msetsma/desk-rail-system/refs/abfcrttw_usb_hub/README.md

ABFCRTTW 4 ft 7-port USB 3.0 hub (4 USB-A + 3 USB-C on one face, USB-C power port on one end, cable out the other).
Identified from the user's screenshot, 2026-11-02.

Size: about 130 x 30 x 17 mm, aluminium, ~92 g. Listings disagree slightly:
- Amazon B0D3D67D5J: 1.18 x 0.67 x 5.12 in
- Newegg HB437: 3 x 1.7 x 13 cm
- eBay HB436: 1 x 0.66 x 5.3 in
Port positions along the face: estimate from product photos. MEASURE before modelling the pocket.
