msetsma/desk-rail-system/refs/apple_magsafe/README.md

Apple MagSafe Charger (puck), for the ACC-04 phone dock pocket. Researched 2026-11-02.

- 25 W model (2nd gen, Sept 2024 onward): Ø55.5 x 4.5 mm, braided cable Ø3 mm.
  Sources: MakerWorld fit models (makerworld.com/en/models/712190, /2793777). Apple publishes no dimensions.
- Original model (2020-2024): about 5.3 mm thick, slightly wider than 55.5 (estimate, same sources).
- Design pocket: Ø55.8 x 4.6 for the 25 W puck. MEASURE the user's own puck with calipers to confirm which model it is.
