msetsma/desk-rail-system/refs/ducky_pad_pro/README.md

duckyPad Pro, user's own standard case (not the low-profile one)
Source: https://github.com/msetsma/ducky-pad-pro (case/standard), downloaded 2026-11-02.
README.md in this folder is the repo's README; this file is our note.

Case envelope from the STLs (bottom + top): 116 x 103 x 24.7 mm (z -9.2..15.5 in case coords).
Keycaps and the printed encoder knobs add roughly 12-15 mm above the top: estimate, MEASURE.
USB-C exits at the rear right (photo DPP Case Finished.png).
Finish: charcoal matte print, light grey keycaps and knurled knobs, a horizontal top/bottom parting line.
