msetsma/desk-rail-system/refs/laptop_arm/README.md

# LAP-01 laptop tray arm: VIVO STAND-V001L (black)

Single-arm laptop tray desk mount with C-clamp (Amazon B00CM9NG1W, ~$40).

## Sources
- VIVO product page: https://vivo-us.com/products/stand-v001l
- Amazon UK listing (metric): https://www.amazon.co.uk/VIVO-Single-Laptop-Notebook-Mount-Black/dp/B00CM9NG1W
- Kitchen and Bath Authority listing: https://www.kbauthority.com/vivo-stand-v001l-laptop-tray-and-desk-mount.html

## Published dimensions
| Item | Value |
|---|---|
| Tray | 14" x 11.8" (355.6 x 299.7 mm; Amazon UK 35.6 x 30 cm) |
| Pole height | 17" (431.8 mm); KBA lists an 18" centre post on older stock |
| Max arm extension | 16.5" (419 mm) |
| Clamp desk thickness | 0.4"-3.4" (10-86 mm), so a 40 mm 2040 bar fits |
| Capacity | 22 lb (10 kg), laptops up to 17" |
| Movement | tilt +-90 deg, swivel 180 deg, rotation 360 deg; height slides on the pole |
| Material | steel, aluminium; black or white |

## Estimates (MEASURE, from product photos)
- Pole diameter 32 mm
- Arm section 35 x 20 mm, two equal segments
- Clamp plate 60 mm wide (X), 6 mm thick; C-spine 8 mm thick
- Tilt head 60 x 50 x 18 mm
- Tray sheet 3 mm thick; front lip 25 mm high
