msetsma/desk-rail-system/refs/klipsch_r40m/README.md

# Klipsch R-40M references

- `product.json`: Klipsch product JSON (R-40M pair). `photos/klipsch_ca_1..9.jpg`: its 9 product images.
- None of these images (checked 2026-10-28) shows a wall or swivel mount. They show the speaker only: front, side, back (bass port + binding posts).
  So there's no reference image for the mount colour (flange / block / swivel ball). The mount parts' current #1c1c1c (`parts/src/SPK-0[2-4]*.json`) is an assumption, not taken from a reference.
