msetsma/desk-rail-system/PROJECT.md

# Project specifics: desk rail system

Companion to the generic `AGENTS.md`. Update this file when project facts or quirks change.

## Files and tools
- Assembly: `desk_rails.solidcraft` (SolidCraft, driven over MCP). It holds only linked part files placed
  with joints from the skeleton parameters. Live app:
  `solidcraft --control 27878 --allow-path "C:\Users\<user>\DEV\CAD\desk"`.
- Skeleton: `skeleton/params.json`, the shared layout and `MEASURE` parameters. Both the assembly and
  every layout-driven part import it. It stores **expressions only** (no values): for numbers, use
  `tools/skeleton_values.py` (`values()`, evaluated with the CLI, cached by hash) or an eval report.
  `skeleton/hw_placements.json` holds the hardware placements.
- Parts: source of truth is the part's **generator** when its script says `"generated_by": "<gen>.py"`
  (most parts: `parts/src/*_gen.py`, `FRM-gen.py`, `parts/lib/src/gen_lib.py`); otherwise the hand-written
  script `parts/src/<PN>_<Name>.json` itself. Never hand-edit a generated script: the next generator run
  overwrites it. A script may name a vendor file to start from (`"input": "refs/..."`). New parts start
  from `parts/_template.json` (materials), get a generator, and follow `docs/PART_BUILD_SPEC.md`.
  - `parts/<PN>_<Name>.solidcraft` are **frozen** outputs: a STEP import plus materials, colours and
    metadata. They're what the assembly links, at about 1 s per insert. Don't edit them by hand.
  - Each part's build history is in `build/parts_hist/<stem>.solidcraft`. Open that one to inspect a part,
    then change the script.
- **Edit loop (fast):**
  1. Edit `skeleton/params.json` or a part script.
  2. Run `python tools/regen_parts.py`. It first re-runs stale generators (generator newer than its script,
     or skeleton newer and the generator uses `skeleton_values`), then rebuilds only the parts whose script
     or skeleton changed, in parallel. It prints the components to refresh. It re-reads the part list after
     the generators, so a part a generator just created or renamed builds in the same pass, and it warns about
     frozen files left without a script (`git rm` them).
  3. **1-3 parts changed:** in the live assembly, run `component.update_links {"component": "<name>"}` for
     each (~0.3 s each), plus `parameters.import` of the skeleton if it changed. **More than that** (any
     skeleton change usually touches ~25 parts): rebuild the assembly (below, ~20 s), then `new_design` +
     `open`. **Never use the bare `update_links {}`**: it re-evaluates every link (~40 s).
     Removing or renaming a skeleton parameter is a skeleton change too. When a change only retires a
     parameter, leave it unused (say so in its comment) and delete it with the next real skeleton change.
- Parameter sweep (parallel, on private copies): `python tools/sweep.py`.
- Console (ACC-00): `parts/src/ACC_layout.py` is the shared layout (bays, device pockets, phone stand) read by
  the bay generator and the device generator; it isn't a skeleton parameter set, so editing it reruns only those
  generators.
- Other tools: `audit.py` (structure and balance), `eval_bodies.py` (body -> part/placement names), `svg2dxf.py`,
  `spk_laid.py` (laid-speaker solve for variants).
- Layout variants (own assembly file, main design untouched): `python tools/build_variant.py <name>` builds
  `variants/<name>/variant.json` (skeleton overrides, `speakers: hung|laid`) into its `out` file, with the
  variant skeleton and its skeleton-driven parts under `variants/<name>/`. `desk_62x32` ->
  `desk_rails_62x32.solidcraft` (D17). Re-run it after a skeleton or part change; it re-solves the laid speaker
  placement and laptop tray height. Checks take `--design desk_rails_62x32.solidcraft`. It can run in parallel
  with `build_assembly.py`: `assembly_finish.py` names its scratch files after the design
  (`build/<design>_finish.json`, `build/<design>_eval.json`).
- Rebuild the whole assembly from scratch (~20 s): `python tools/build_assembly.py --out desk_rails.solidcraft`.
  Build straight to that path (the design name comes from the build path, so a copied file keeps the
  wrong name). Run `new_design` in the live app first, then `open`.
  `tools/assembly_finish.py` adds materials, properties, views and display rows.
- The desk (DSK group) stays in the main assembly rather than a nested file, as tested on 2026-10-28:
  - a linked sub-assembly is flattened to one BOM row
  - links don't chain, so every change becomes a two-step refresh
  - all of DSK costs < 1 s to insert
- Legacy single-timeline model and `docs/COMPLIANCE_PLAN.md`: removed 2026-10-31; recover from git history if needed.
- Headless CLI: `solidcraft-cli run <script.json> [--in X] --save Y`.
- Narrow clearance after a change: `python tools/near_check.py <body prefixes>` (~4 s). It checks each
  changed body against its bbox neighbours and skips hardware-on-extrusion contacts. Open mesh bodies
  (the converted chair) can't be checked exactly; it falls back to their bboxes (`BBOX ... inspect`).
  `--print-params` prints the commands for the live app. `--include-mating` keeps the contacts (slow).
  New catalog hardware that seats face-to-face on an extrusion (end caps, brackets) must be added to
  `near_check.MATING`, or its exact contact check runs for minutes.
  Its scratch files are per design, so checks on the main design and a variant can run in parallel.
  It passes `skip_within: component`, so bodies in the same group (ACC-00 devices in their bays) are never checked
  against each other: run `inspect.clearance` on those pairs without it.
- Sightlines + laptop fit: `python tools/sightlines.py [--set lap_az=36 ...]` (seconds). Ray-casts from the Eye to the
  speaker baffles, monitor screens and laptop screen, and box-checks the laptop against monitors, speakers and the frame.
  A coarse grid search can miss a small block: re-run the chosen point at the default resolution.
- Full check: `tools/check.py` (slow; run only on request). BOM: `tools/bom.py` -> `BOM.md`.
- Decision log and extrusion rules: `docs/EXTRUSION_GUIDE.md`. Cite rule IDs (J*, M*, P*, W*) and
  log decisions (D*) there.

## Standards and constraints
- Extrusion: Misumi HFS5 (5 series) only, ordered black anodized as HFSB5 (D23, same section); the 8020 and V-slot variants are retired. Profiles come from
  `profiles/misumi_hfs5_*.dxf`, so `rail_l` and `rail_s` follow the profile and aren't free parameters.
- Buy, don't fabricate: joints use catalog parts. Vendor machining is OK, and user drilling is OK when
  the user agrees.
- Desk frame: DeskHaus Apex Pro 4-leg (Jiecang OEM), finished in Silver. No CAD exists; it's modelled
  from the dimension sheet and photos in `refs/`. `MEASURE` parameters are estimates.

## Conventions (for the cad-best-practices skill)
- Part numbers belong to part **files**, not occurrences. Group components `DSK-00`, `FRM-00`, `HW-00`,
  `MON-00`, `SPK-00`, `PC-00`, `INP-00`, `LAP-00`, `CHR-00`, `ACC-00`, `REF-00`; parts `DSK-01`…, library `HW-L01`…. Add `Rev X` when a
  part is released. `DSK-00` is grounded. The full list is in `docs/PART_BUILD_SPEC.md`.
- One file per left/right pair when a 180° turn about Z reproduces the other side. Mirror-image parts
  (side rails, hanger plates, keyboards) get two files.
- Purchased reference models (speaker, mouse, chair, laptop, console devices) may hold several bodies, one per finish.
- Appearance: purchased parts get their real finish:
  - DeskHaus Silver powder-coated steel frame #a8acaf (refs/apex_pro)
  - black anodized extrusion (HFSB5) and gussets (HBLFSNB5) #1d1e20 (D23)
  - joining plates, 45 deg brackets and hanger plates: painted / powder-coated black by the user #1a1a1a
  - black polyamide end caps (HFC5-4040-B) #141414
  - black standoffs and HBLTDB5 #1d1e20; M6x55 black oxide #2b2b2b
  - printed console parts (ACC-01..07) charcoal #34373b, inlay light grey #c9cccf
  - PC walnut slat front #634433
  - dark grey PET felt panels #3a3c3f (estimate, confirm from samples)
  - desktop (IKEA KARLBY walnut veneer, 503.352.08) #6b4a32, estimated from product descriptions

  Reference geometry is red.
- Materials are the custom set in `parts/_template.json`. They are stored in each part as
  `com.setsma.desk {Material, ReleaseState, Source}`, and the assembly re-applies them, because links
  don't carry them.
- Masses are envelope estimates: legs, PC case and monitors are solid blocks, so `mass_g` overstates them.

## SolidCraft capabilities (spike 2026-10-28, CLI v0.24.0)
- Script format: `{"commands":[{"command": id, "params": {...}}]}`. Use forward slashes in paths.
- `solidcraft-cli` builds and saves headless while the live app is open. Parallel runs are fine.
- Linked parts: `component.insert_design {path, name, parent?, reuse?}` stores a STEP copy plus a link.
  It only refreshes on `component.update_links {}`. `reuse:true` adds another occurrence of the same
  component.
- **Linked parts can't read assembly parameters**: there's no per-occurrence override, and insert_design
  ignores extra keys. Layout-driven parts import the shared skeleton instead with
  `parameters.import {path}`. Re-importing overwrites the values and rebuilds (tested).
- **Standard placement**: a planar joint from the root origin to the part's local origin:
  `{type:"planar", a:{occurrence:0, point:[0,0,0], z:[0,0,1], x:[1,0,0]}, b:{occurrence, point:[0,0,0], z:<zl>, x:<xl>}, flip:true, values:["<x>","<y>","<yaw>"], offset:"<z>", angle:"0 deg"}`.
  - `zl` and `xl` are the part-local directions that land on world +Z and +X; they encode any fixed
    rotation (a fixed half turn is `xl:[-1,0,0]`).
  - `angle:"0 deg"` is required. Without it, SolidCraft adds a half turn whenever that turns b less.
  - Only parametric yaws go in `values`. The placement follows parameter changes.
  - `occurrence.move` and `joint.origin` points take numbers only. `joint.drive` replaces expressions.
- Metadata: `component.metadata.set {component, part_number, description, revision, properties}` and
  `document.metadata.set`. Linked parts copy document metadata **once, at insert**. Material and free
  properties don't come through.
- Materials: `material.create {name, density_g_cm3}`, `material.assign {bodies, material}`.
- BOM: `assembly.bom {levels, group_by, path}`. The CSV has no material column; the JSON includes properties.
- Appearance: `appearance.assign {bodies|components, color}`; precedence face > body > component > material.
- Views: `view.save {name, camera:{target, yaw, pitch, distance}}`. Yaw 0 looks from the front (-Y);
  yaw < 0 orbits toward +X. `snapshot --view NAME` works.
- **No display states**: use config rows that suppress link features
  (`config.row {name, values:{"suppress:<feature>": true}}`). Rows: Full, Frame only, No desktop,
  Monitors + speakers, Rails only, Desk only, Desk + rails, No chair. Named views don't carry a row:
  pair `Rails`/`RailsBack`, `Desk` and `DeskRails` with their row by hand.
- Home view (`view.home`) always fits the whole model; its zoom isn't configurable. Use the `Overview` view.
- Naming: `timeline.rename`, `timeline.group {name, features}`. `solid.extrude` ignores `name` (the body
  stays `Body1`), so use `body_name` and check it. Patterns, chamfers and mirrors take `name`.
- `solidcraft-cli script` fails on designs with components (#886).

## Known quirks
- SolidCraft `body.rename` renames the string across all features.
- The MCP call timeout moves long calls to the background, and `pending` may say nothing is running.
- MCP `open` of a path whose design is already loaded (even after the file changed on disk) keeps the
  in-memory design. Run `new_design` first, then `open`.
- Linked inserts split multi-lump bodies into separate bodies (`PC_FrontSlats (2)` …).
- `component.insert_design` and `update_links` **re-evaluate the part's history**: an insert costs about
  what the part takes to build. Profile slow parts with
  `solidcraft-cli run <script> --timings --profile --json-out t.json`.
  - Booleans on the detailed HFS5 DXF profile are the expensive case: one `solid.hole` with 8 counterbores
    took 46 s.
  - The assembly build was ~120 s before parts were frozen, the two side rails ~105 s of it (2026-10-28);
    with frozen links it is ~20 s.
- `component.update_links {}` re-evaluates every link, even unchanged ones (~40 s). Pass `component`.
- Full assembly builds log repeated non-fatal `knot vector consists single value` panics (source part
  not yet identified; likely a vendor NURBS body). The run still succeeds.
- Edge/face pick points (`solid.chamfer`/`fillet` `edges`, `appearance.assign` `faces`) and `sketch.create`
  origins are plain numbers. Generators compute them from `skeleton_values.values()` or their own local
  constants (AGENTS §3). DSK-02 broke when a hand-typed point missed the new `ts_h`; the stale stored
  skeleton values had also put the PC-01/02 fillet picks on the wrong edges.
- Line endings: `.gitattributes` stores all text as LF; Windows generators may write CRLF and git
  normalises on add, so don't hand-preserve line endings. Working copies can still be CRLF (e.g.
  `FRM-gen.py`): edit scripts that match multi-line text must convert the pattern to the file's line ending.
- SPK-01's logo outlines live in `refs/klipsch_r40m/R40M_logo_sketch.json` (a JSON in `parts/src` would be taken for
  a part script). `regen_parts.py` doesn't track that file: after editing it, run `regen_parts.py --force SPK-01`.
- `inspect.clearance` can report `0.000 mm` for a real 0.1 mm gap (seen on the laptop clamp vs the 2040 bar).
  Treat sub-0.2 mm "near" values as contact-level, not as a measurement.
- MCP `parameters.export` returns the full text even when given a `path`. `component.list` on the full
  assembly is large; use `solidcraft-cli ... --results --json-out` and summarize it.
- Eval names a body in a repeated placement with its occurrence path:
  `Leg (DSK-00 Desk frame:1/DSK-04 Leg:3)`.
- `solidcraft-cli eval <script> --in X` ignores the script; use `run --in X --save tmp`, then `eval`.
- An `XZ` sketch's v axis is world **-Z** (normal +Y): generators negate z (`FRM-gen._pt`). Expression points also work in
  `sketch.arc.three_point`; drawing arcs through their 45 deg point avoids CW/CCW sign slips. There's no `parameters.set`
  in scripts: inline the expressions.
- `sketch.rectangle.*` rejects expressions; use `sketch.line` with expression points. `sketch.create`
  takes a numeric origin only, and `{face, body}` needs `index`.
- Mesh imports (`file.insert_mesh`: STL/OBJ/glTF) stay mesh bodies: no STEP export, and `insert_design` refuses a
  design with only mesh bodies. Vendor meshes go through `tools/mesh_step.py` (planar-face STEP, imports as B-rep;
  ~2 s linked insert per 11k triangles; the chair keeps the full 35k for looks). Keep touching pieces unwelded: edges with 3+ faces break STEP export. Reduce glTF meshes by vertex clustering
  (`MON-03_convert._cluster`): quadric decimation (fast-simplification) tears them open along UV seams, and once
  welded it hardly reduces them.
  DWG -> DXF: LibreDWG `dwg2dxf` (C:/Users/2015m/cad_tools/libredwg/), see refs/herman_miller_mirra2/README.md.
- Misumi: 3D CAD is generated server-side (slow) and needs a login or email. HFS5 extrusion 3D
  CAD isn't offered; profiles come from DXFs in `profiles/` / `refs/ext_*`.
- README image (`docs/images/desk_overview.png`): model screenshots (`screenshot source:model`) always draw
  black edges, which turn the chair mesh into a wireframe, and `view.visual_style` doesn't affect them. Render it
  with `render.settings.set` (setup `Readme`: camera target [0,0,720], yaw 0.6, pitch 0.42, distance 2700,
  1600 x 1000, background [46,51,64]) then `render.start {setup, integrator:"raytrace", raytrace:{budget:"studio"}}`
  and `render.export` (~10 s). GitHub caches README images for a few minutes.
- Rendering: the full assembly (~330k triangles) exceeds the CPU preview cap (262k); use CPU raytrace with
  `budget: "studio"` or GPU path. The GPU path tracer needs Vulkan, but the Windows viewport defaults to D3D12
  (issue #7623), so `%APPDATA%\SolidCraft\graphics.json` sets `{"backend": "vulkan"}` (2026-10-29). The first
  GPU render compiles shaders (~3 min, ~7 GB RAM). `assembly_finish.py` recreates the `Readme` render setup on every
  rebuild; any other setup saved in the assembly (e.g. `Hero`) is lost by a rebuild unless added there.
