msetsma/desk-rail-system/refs/klipsch_r40m/photos/klipsch_ca_1.jpg

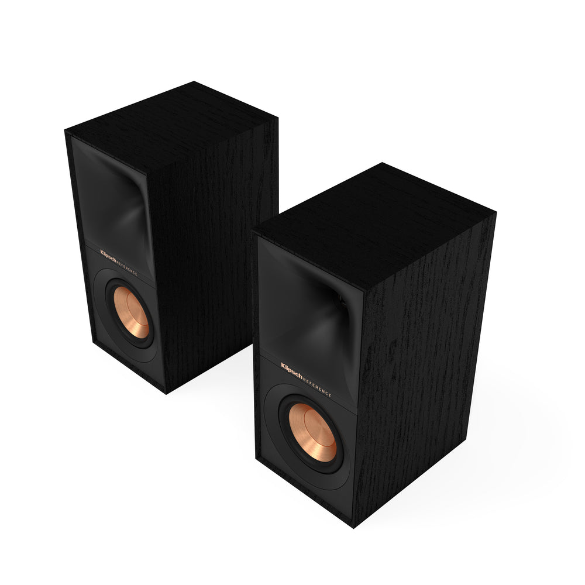
refs/klipsch_r40m/photos/klipsch_ca_1.jpg
