msetsma/desk-rail-system/refs/klipsch_r40m/photos/klipsch_ca_6.jpg

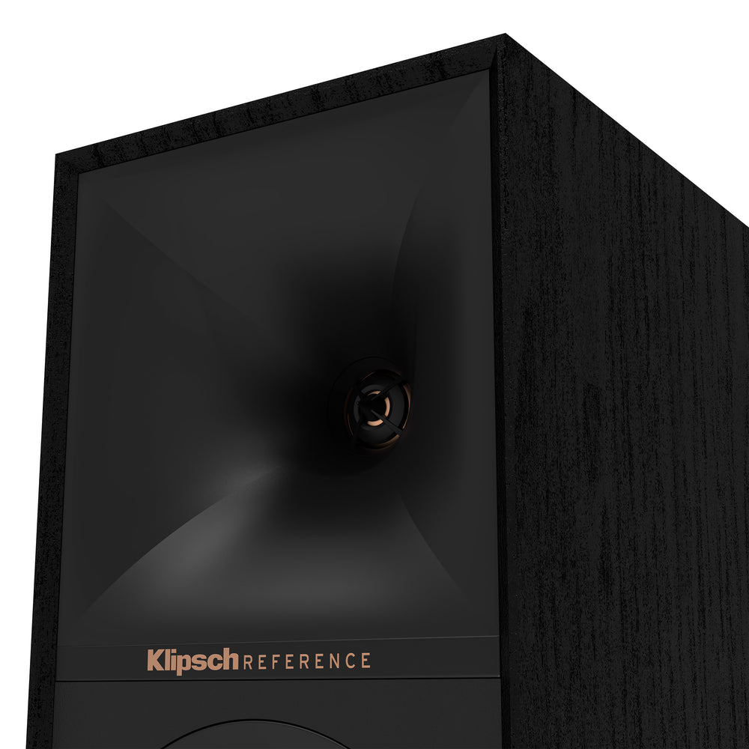
refs/klipsch_r40m/photos/klipsch_ca_6.jpg
