msetsma/desk-rail-system/refs/visual_black_felt/HBLTD5_drawing.png

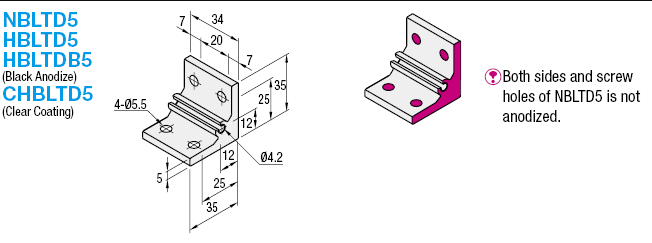
refs/visual_black_felt/HBLTD5_drawing.png
