msetsma/desk-rail-system/refs/visual_black_felt/HFC5_drawing.png

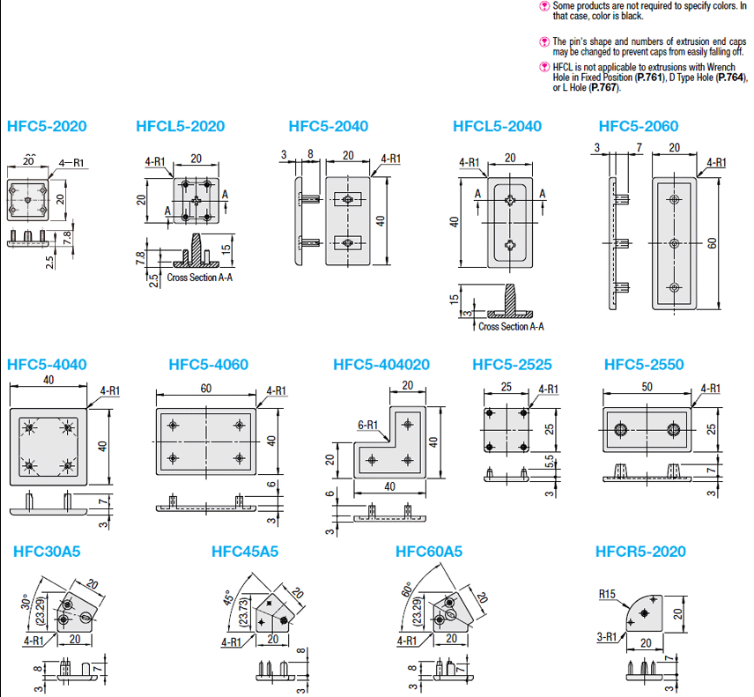
refs/visual_black_felt/HFC5_drawing.png
