msetsma/desk-rail-system/refs/visual_black_felt/HFCB5_drawing.png

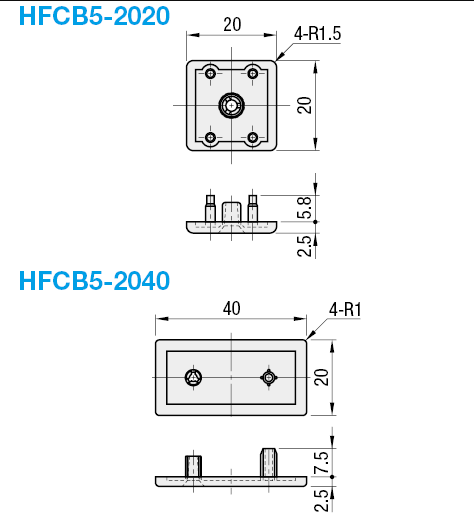
refs/visual_black_felt/HFCB5_drawing.png
