msetsma/desk-rail-system/BOM.md

# Bill of materials

Generated by `tools/bom.py` from the part-number metadata in `desk_rails.solidcraft` (`assembly.bom`). Do not hand-edit; rebuild.

52 part numbers, 120 items.

| Group | Part numbers | Items |
|---|---|---|
| ACC-00 Crossbar console | 12 | 12 |
| CHR-00 Chair | 1 | 1 |
| DSK-00 Desk frame | 5 | 13 |
| FRM-00 Monitor rail frame | 10 | 16 |
| HW-00 Frame hardware | 8 | 58 |
| INP-00 Input devices | 4 | 4 |
| LAP-00 Laptop | 3 | 3 |
| MON-00 Monitors | 2 | 2 |
| PC-00 PC under-desk | 3 | 3 |
| SPK-00 Speakers | 4 | 8 |

## ACC-00 Crossbar console

| Qty | Part number | Description | Material | Rev | Notes |
|---|---|---|---|---|---|
| 1 | ACC-01 | Desk cable grommet (printed) | ASA/PETG print (ABS density) | A |  |
| 1 | ACC-02 | Console audio bay (printed) | ASA/PETG print (ABS density) | A |  |
| 1 | ACC-05 | Console duckyPad bay (printed) | ASA/PETG print (ABS density) | A |  |
| 1 | ACC-06 | Console inlay line (printed, light grey) | ASA/PETG print (ABS density) | A |  |
| 1 | ACC-07 | Phone stand (printed) | ASA/PETG print (ABS density) | A |  |
| 1 | ACC-11 | Focusrite Scarlett Solo 3rd Gen interface, 144 x 44 face x 96 deep, red anodised body, front jacks/knobs proud toward -Y, rear USB-C + RCA toward +Y | Al 6063-T5 | A |  |
| 1 | ACC-12 | ABFCRTTW 7-port USB 3.0 hub, 130 x 30 port face x 17 deep, 4 USB-A then 3 USB-C along +X in the -Y face, captive cable d3 x 12 stub out of the -X end (back half) | Al 6063-T5 | A |  |
| 1 | ACC-13 | Apple iPhone 16 Pro Max in a case, landscape, 168 x 82 x 12 (case), screen toward -Y inset 1 mm, camera plateau 1.5 mm proud on the back (+Y) at +X/+Z | PC | A |  |
| 1 | ACC-14 | Apple MagSafe Charger 25 W puck d55.5 x 4.5, charging face toward -Y, aluminium back, cable d3 x 20 radially out of the bottom (-Z) | Al 6063-T5 | A |  |
| 1 | ACC-15 | USB-C fingerprint reader dongle, 30 x 15 x 7, round sensor d9 on the -Y face, USB-C plug 6.5 out of the +X end | ABS | A |  |
| 1 | ACC-16 | duckyPad Pro in the user's standard printed case (116 x 103 x 24.7), 20 keycaps 4 x 5 at 19 mm, 2 knurled knobs (rear right), 2 buttons (front right), OLED | ABS | A |  |
| 1 | ACC-17 | KVM key | ABS | A |  |

## CHR-00 Chair

| Qty | Part number | Description | Material | Rev | Notes |
|---|---|---|---|---|---|
| 1 | CHR-01 | Herman Miller Mirra 2 work chair, Butterfly (Suspension) back, adjustable arms | ABS (stand-in for glass-filled nylon frame/base and polyester textile); steel cylinder | A |  |

## DSK-00 Desk frame

| Qty | Part number | Description | Material | Rev | Notes |
|---|---|---|---|---|---|
| 1 | DSK-01 | Desktop slab desk_w x desk_d x desk_t (IKEA KARLBY walnut veneer, 503.352.08), with the ACC-01 cable grommet hole (grom_d at x 0, y grom_y | Walnut | A |  |
| 2 | DSK-02 | Apex Pro (Jiecang OEM) top support | Steel powder-coated | A |  |
| 4 | DSK-03 | Apex Pro collapsing channel bar (one of 4 | Steel powder-coated | A |  |
| 4 | DSK-04 | Apex Pro (Jiecang OEM) 3-stage lifting column, narrowest at the top (DeskHaus renders) | Steel powder-coated | A |  |
| 2 | DSK-05 | Apex Pro foot | Steel powder-coated | A |  |

## FRM-00 Monitor rail frame

| Qty | Part number | Description | Material | Rev | Notes |
|---|---|---|---|---|---|
| 2 | FRM-01 | Upright, Misumi HFSB5-4040, L = up_below + hang_t + desk_t + up_above | Al 6063-T5 | A | access holes for the crossbar and side-rail / speaker-arm anchors (M2) |
| 2 | FRM-02 | Crossbar, Misumi HFSB5-2040 (40 in Z, 20 in Y), L = 2*up_xc - rail_l (between upright inner faces) | Al 6063-T5 | A | both ends tapped M5 for end anchors (M1, D8) |
| 1 | FRM-03L | Side rail L, Misumi HFSB5-4040 drilled for 4 M6 through-bolts (D9) | Al 6063-T5 | A | rear end tapped M5 (M1, D8) |
| 1 | FRM-03R | Side rail R, Misumi HFSB5-4040 drilled for 4 M6 through-bolts (D9) | Al 6063-T5 | A | rear end tapped M5 (M1, D8) |
| 3 | FRM-04 | Stile, Misumi HFSB5-2040 (40 in X, 20 in Y), L = bar2_z - bar1_z - rail_l (between crossbars) | Al 6063-T5 | A | both ends tapped M5 for end anchors into the crossbar slots (M1, D7) |
| 1 | FRM-05 | Privacy panel, 12 mm PET felt, W = desk_w - 2*pnl_side, H = pnl_drop + desk_t + pnl_above, top corners R pnl_r (V1) | PET felt | A |  |
| 2 | FRM-06 | Knee brace (D20), Misumi HFSB5-2040, 40 across X, both ends cut 45 deg | Al 6063-T5 | A | cut to length with both ends mitred 45 deg, long edge = brace_leg*sqrt(2) (D20) |
| 1 | FRM-07L | Hanger plate L (D21) | Steel powder-coated | A | 5 x 80 flat bar cut to 530, 14 x M5 countersinks + 3 slots 7 x 13 (vendor-machined plate, D21) |
| 1 | FRM-07R | Hanger plate R (D21) | Steel powder-coated | A | 5 x 80 flat bar cut to 530, 14 x M5 countersinks + 3 slots 7 x 13 (vendor-machined plate, D21) |
| 2 | FRM-08 | Side panel (corner return), 12 mm PET felt on the upright's outer face, on 12 mm standoffs clear of the HPTTD5 screw heads (7.3 mm). D = rail_l + pnl_back_gap (upright front face to the privacy panel's front face, which covers its back edge), H = privacy panel height - pnl_r (top meets the corner arc's lower end, so the arc caps it from behind) | PET felt | A |  |

## HW-00 Frame hardware

| Qty | Part number | Description | Material | Rev | Notes |
|---|---|---|---|---|---|
| 4 | HBL45TD5 | Misumi HBL45TD5 45 deg angled bracket, 5 series, 2 slots (34 wide), 4 x M5, 1470 N, painted / powder-coated black by user (D23) | Al 6063-T5 | A |  |
| 16 | HBLFSNB5 | Misumi HBLFSNB5 cast bracket, 5 series, black anodized (same as HBLFSN5, D23) | Al ADC12 cast | A |  |
| 2 | HBLTDB5 | Misumi HBLTDB5 thick bracket, 5 series, 2 slots (34 wide, 35 x 35 x 5), black anodized, 4 x M5, 1470 N (D23) | Al 6063-T5 | A |  |
| 6 | HFC5-4040-B | Misumi HFC5-4040-B end cap, black polyamide, 40 x 40 x 3, press fit (D23) | PA6 | A |  |
| 4 | HPTLD5 | Misumi HPTLD5 L-joint plate, 5 series, 2.3 mm, painted / powder-coated black by user (D23) | Steel powder-coated | A |  |
| 4 | HPTTD5 | Misumi HPTTD5 T-joint plate, 5 series, 2.3 mm, painted / powder-coated black by user (D23) | Steel powder-coated | A |  |
| 8 | ISO 4762 M6x55 | Socket head cap screw M6x55, black-oxide steel (simplified, no thread) | Steel black-oxide | A |  |
| 14 | Standoff M5x12 d10 | Round standoff d10 x 12, M5 through bore (simplified), black (Misumi black-anodized round standoff or Lyn-Tron -14 finish, D23) | Steel black-oxide | A |  |

## INP-00 Input devices

| Qty | Part number | Description | Material | Rev | Notes |
|---|---|---|---|---|---|
| 1 | INP-01 | Mouse pad 16.5in square | ABS | A |  |
| 1 | INP-02 | Razer DeathAdder V3 Pro mouse (vendor CAD, 10 bodies) | ABS | A |  |
| 1 | INP-03 | ZSA ErgoDox EZ left, black case, user's own light grey SA keycaps (38 keys, flat/untented). Bodies | ABS | A |  |
| 1 | INP-04 | ZSA ErgoDox EZ right (mirror of left), black case, user's own light grey SA keycaps (38 keys, flat/untented). Bodies | ABS | A |  |

## LAP-00 Laptop

| Qty | Part number | Description | Material | Rev | Notes |
|---|---|---|---|---|---|
| 1 | LAP-01 | User-built laptop mount (placeholder envelope) | Al 6063-T5 | A |  |
| 1 | LAP-02 | Apple MacBook Pro 14in (M4, 2024), deck tilted lap_kb_tilt front-down with the tray, lid open to lap_lid so the screen matches the monitor tilt (purchased, reference model) | Al 6063-T5 | A |  |
| 1 | LAP-03 | User-built laptop tray (placeholder) sized to the MacBook Pro 14in footprint, front lip the laptop rests against, tilted lap_kb_tilt front-down on a hinge barrel + stem to the LAP-01 puck | Al 6063-T5 | A |  |

## MON-00 Monitors

| Qty | Part number | Description | Material | Rev | Notes |
|---|---|---|---|---|---|
| 1 | MON-01 | Gigabyte M32U 31.5in 4K monitor, stand removed, VESA 100x100 mounted (purchased, reference model) | ABS | A |  |
| 1 | MON-02 | Side monitor, generic 27in 16:9 in portrait, VESA 100x100 mounted (model not picked yet). Thin bezel top/bottom/inner edge, landscape chin on the outer (-X) edge | ABS | A |  |

## PC-00 PC under-desk

| Qty | Part number | Description | Material | Rev | Notes |
|---|---|---|---|---|---|
| 1 | PC-01 | Fractal Design North, Charcoal Black, Mesh side (visual model | Steel powder-coated | A |  |
| 1 | PC-02 | Fractal North front panel, dark walnut | Walnut | A |  |
| 1 | PC-03 | Under-desk PC C-bracket (top plate screwed into the desktop underside, right side, bottom, left lip), strap_w wide | Steel powder-coated | A |  |

## SPK-00 Speakers

| Qty | Part number | Description | Material | Rev | Notes |
|---|---|---|---|---|---|
| 2 | SPK-01 | Klipsch R-40M bookshelf speaker (purchased, reference model, multibody per finish) | MDF cabinet, polymer/ABS drivers and trim | A |  |
| 2 | SPK-02 | Speaker mount flange plate on the upright front face | Steel powder-coated | A |  |
| 2 | SPK-03 | Speaker mount arm block from the flange to the swivel | Steel powder-coated | A |  |
| 2 | SPK-04 | Speaker mount swivel ball, 12 mm | Steel powder-coated | A |  |

## Slot fasteners (estimate)

Not modelled; counts from the catalog per placed part.

| Qty | Item |
|---|---|
| 132 | M5 bolt + T-nut pairs into slots (resin-coated / locking nuts, F4; 6.8 N*m, F3) |
| 26 | spare pre-assembly T-nuts, 2 per member (F2) |
| 12 | end anchors / end-tap screws (D8) |
| 30 | other screws (VESA M4, panel) |
