msetsma/desk-rail-system/refs/ducky_pad_pro/DPP Case - Bottom.step

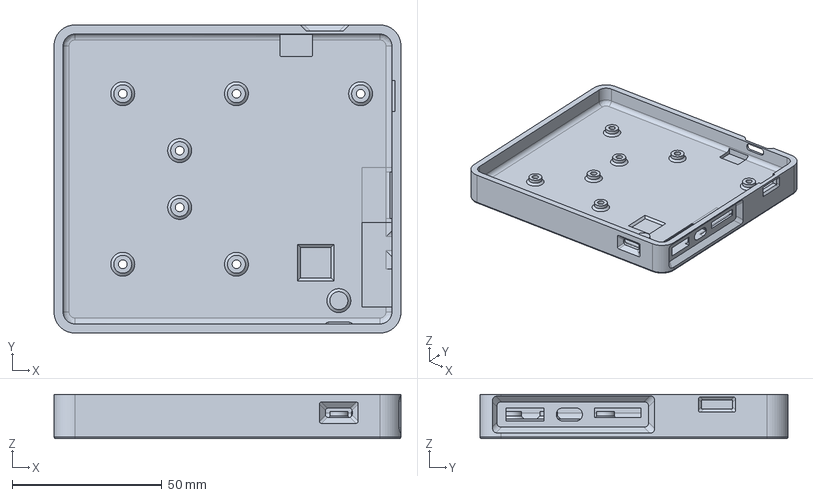
[picture p13: CAD file, 2026-11-02]
refs/ducky_pad_pro/DPP Case - Bottom.step
116.0 x 103.0 x 14.8 mm
