msetsma/desk-rail-system/refs/ducky_pad_pro/DPP Case - Top.step

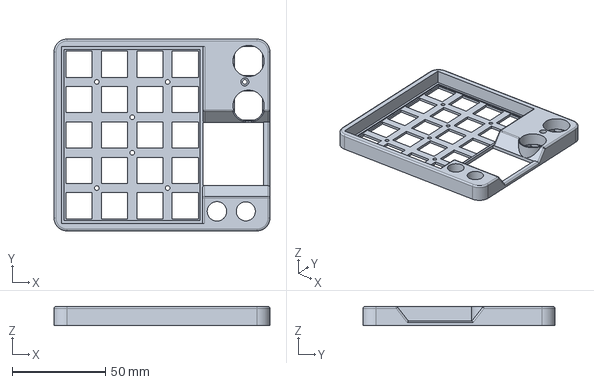
[picture p14: CAD file, 2026-11-02]
refs/ducky_pad_pro/DPP Case - Top.step
116.0 x 103.0 x 10.2 mm
