msetsma/desk-rail-system/refs/ducky_pad_pro/DPP Case - Button.step

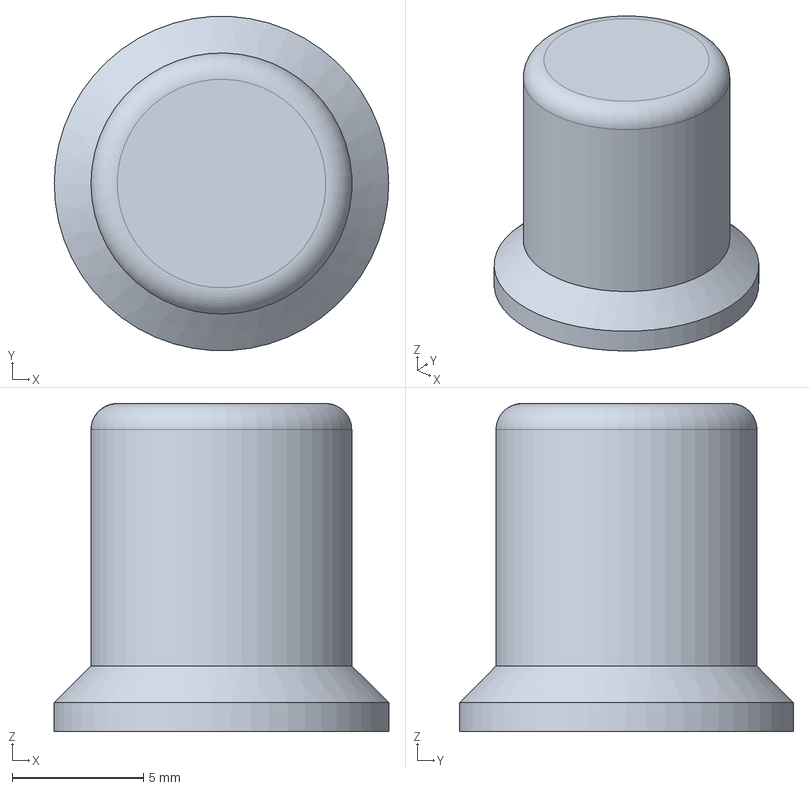
[picture p15: CAD file, 2026-11-02]
refs/ducky_pad_pro/DPP Case - Button.step
12.7 x 12.7 x 12.5 mm
