msetsma/desk-rail-system/profiles/misumi_hfs5_2040.dxf

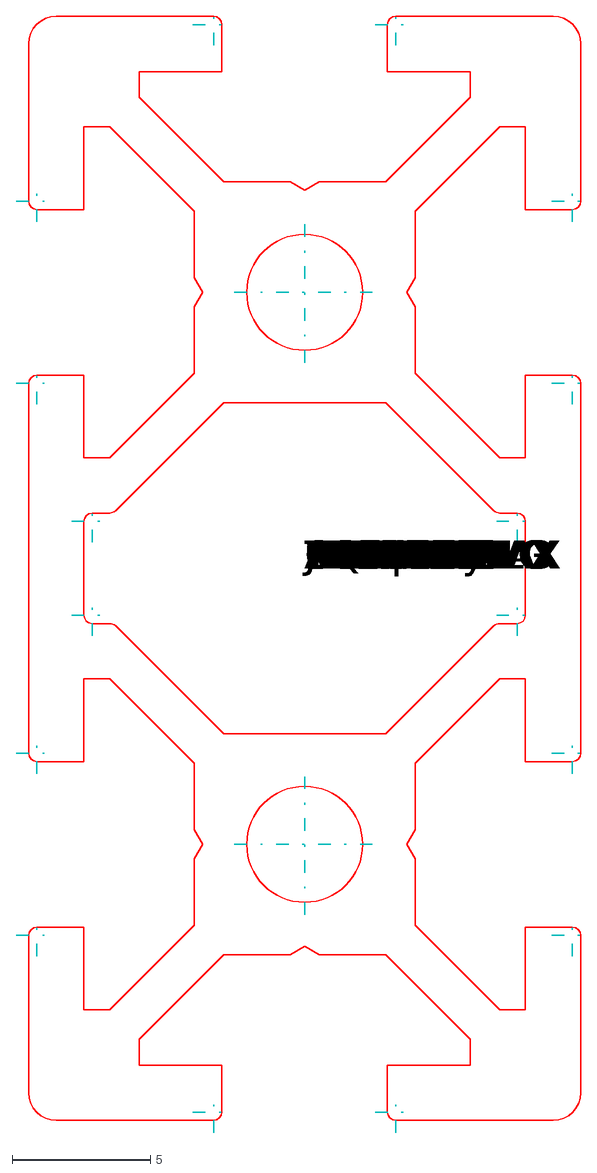
[picture p16: CAD file, 2026-10-27]
profiles/misumi_hfs5_2040.dxf
20.4 x 40.4
