msetsma/desk-rail-system/profiles/misumi_hfs5_4040.dxf

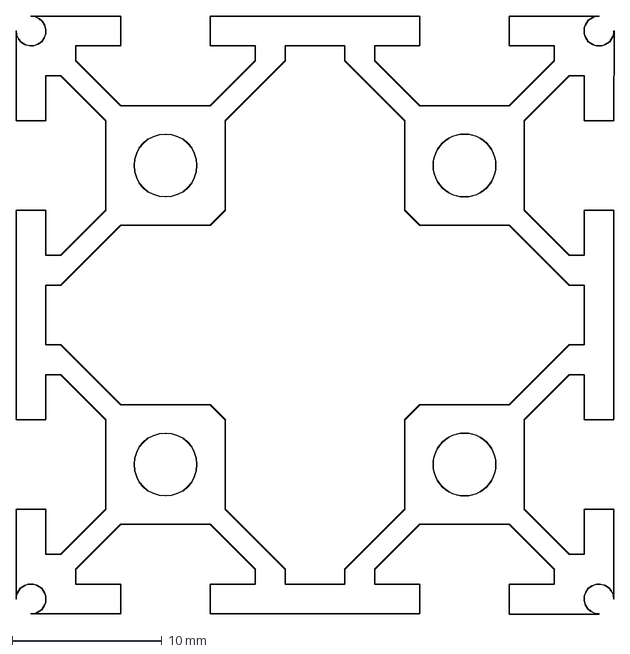
[picture p17: CAD file, 2026-10-27]
profiles/misumi_hfs5_4040.dxf
40.0 x 40.0 mm
