msetsma/desk-rail-system/(list of files, cad)

Other CAD files:
refs/ducky_pad_pro/DPP Case - Bottom.stl
refs/ducky_pad_pro/DPP Case - Top.stl
