msetsma/desk-rail-system/docs/EXTRUSION_GUIDE.md

# Aluminum Extrusion Guide

Rules for designing and building with 20-series T-slot extrusion (Misumi HFS5 default; 80/20
20-series and V-slot behave the same). Every rule has an ID. Cite it when we make a decision
("side rail joint: J3 + J5"), and log the decision at the bottom.

**The one-line version:** the profile is almost never the weak spot. The **joints** are. Wobble is
a *stiffness* problem, not a strength problem. Fix it with triangles, wide bolt spacing and joints
braced in the plane of the load. Bigger extrusion comes last.

---

## 1. Loads: know which way it pushes

Every joint decision starts with: *what load, in which direction, at this joint?*

| Load type | What it looks like here | What resists it best | What resists it worst |
|---|---|---|---|
| **Axial tension** (pull apart) | crossbar pulled away from upright | anchor / end fastener (load runs down the profile axis) | T-nuts gripping thin slot lips |
| **Axial compression** (push together) | side rail end pushed into upright face | the profile itself, ends cut square and bearing on each other | nothing special needed if ends are square |
| **Shear / slip** (slide along slot) | monitor weight trying to slide a stile down the crossbar | members **resting on** a member below; many bolts; serrated or locking nuts | a single T-nut holding by friction |
| **Bending moment** (rotate the joint) | monitors leaning forward, tipping uprights | flat plate or gusset **in the plane of the bending**, bolts spread wide | a 2-hole bracket on one side; blind / in-slot connectors |
| **Torsion** (twist a member) | monitor hanging off the front face of one bar | closed / square sections (4040); tie two bars together so twist becomes push-pull | 2040 / 2020 open sections over long spans |
| **Dynamic / vibration** | typing, bumping the desk, desk motor moving | triangles, preload, locking fasteners | anything relying on friction alone |

- **L1. Find the load path.** Trace each load from where it's applied (monitor) to the ground (feet).
  Every joint on that path must handle that load *type*. One weak joint sets the stiffness of the whole path.
- **L2. Rest, don't hang.** Where possible a member should sit *on* the member below it, so the
  load goes straight down through the metal. A T-nut joint that only holds by friction can slip.
- **L3. Compression beats tension.** Arrange members so loads push joints together, not pull them apart.
- **L4. Short lever arms.** Moment = weight × distance. Mount loads close to the structure
  (direct VESA instead of arms is a big win). Halving the offset halves the moment on every joint.

## 2. Profiles: size and orientation

Misumi HFS5 values (A6005C-T5, E ≈ 70,000 N/mm²):

| Profile | Mass | I (weak axis) | I (strong axis) | Torsion |
|---|---|---|---|---|
| 2020 | 0.50 kg/m | 0.74×10⁴ mm⁴ | 0.74×10⁴ | poor |
| 2040 | 0.88 kg/m | 1.36×10⁴ | 5.13×10⁴ | poor (open, slotted) |
| 4040 | 1.28 kg/m | 8.89×10⁴ | 8.89×10⁴ | good (square) |

- **P1. Orient the long side in the bending plane.** A 2040 is 3.8× stiffer bending across its
  40 side than across its 20 side. Put the 40 dimension parallel to the load's direction.
- **P2. Span is cubed.** For a beam supported at both ends, sag grows with **L³**. A 25% shorter span
  sags about half as much. Shorten spans before upsizing profiles.
- **P3. Cantilever is squared.** For a post loaded by a moment at its top, deflection grows with
  **L²** (δ = M·L² / 2EI). Keep posts as short as the design allows.
- **P4. Open sections hate twist.** Never let a single 2040 / 2020 carry a twisting load over a
  long span. Tie two parallel bars together (a ladder) so the twist becomes push-pull on two
  bars, or use 4040.
- **P5. Size for stiffness, not strength.** Misumi's guideline: allowable load = load that
  bends the beam by **1/1000 of its length**. Stress is rarely the limit at desk scale (our
  2040 posts see about 1.5 MPa against roughly 200 MPa yield).
- **P6. Upsize when:** a member carries twist you can't tie out (P4), needs a wider face for
  bolt spacing (J4), will get future loads (overhead bar, shelf), or you just want the look.
  Otherwise upsizing is the most expensive and least effective fix for wobble.

**Quick formulas** (E = 70,000 N/mm², mm / N units):
- Cantilever, end moment M: δ = M·L² / (2·E·I)
- Cantilever, end force F: δ = F·L³ / (3·E·I)
- Simple span, center force F: δ = F·L³ / (48·E·I) (fixed ends: ÷4; real bolted joints land between)

## 3. Joints: the weak spot

### Connection types, ranked for load-bearing joints

| Rank | Connection | Best at | Weak at | Notes / rating |
|---|---|---|---|---|
| 1 | **Anchor + gusset / tab bracket** together | everything | needs machining | 80/20's standard "high load" combo |
| 2 | **Gusset / tab bracket, 4-bolt** (Misumi HBLFSD5 type) | bending, twist, vibration | blocks slot faces | HBLFSD5: 1470 N allowable |
| 3 | **Flat joining plate** (L / T / 4-5 hole) on coplanar faces | bending **in the plate's plane**; wide bolt spacing | loads that push out of its plane | needs the two faces flush (coplanar) |
| 4 | **Anchor / end fastener / end-tap screw** (internal) | tension, compression, squareness, hidden | bending and twist (nothing braces the outer faces) | locate + clamp; don't rely on it alone for moment |
| 5 | **2-bolt L bracket** (Misumi HBLFSN5 type) | light-to-medium general joints | can rock unless paired on opposite side | HBLFSN5: 1176 N allowable |
| 6 | **Blind / in-slot / hidden corner connector** | clean looks | everything structural | Misumi blind: 620 N; van builders report breakage |

### Joint rules

- **J1. Brace the joint in the same plane as the bending.** If monitors tip an upright
  front-to-back, the plate or gusset must lie in the front-to-back (side) plane. A bracket in
  the wrong plane does almost nothing.
- **J2. Combine internal + external.** An anchor or end-tap pulls the joint tight and keeps it square. An external
  plate or gusset resists rotation. On any joint that carries monitors, use both.
- **J3. Flush faces enable plates.** Design members so faces line up (coplanar). Then a
  flat plate can span both. This is why the side rail butts the upright with outer faces flush.
- **J4. Spread the bolts.** A joint's resistance to rotation is roughly force × bolt spacing.
  4 bolts spread 80 mm beat 2 bolts 20 mm apart by about 4×. Use long plates on load-bearing joints.
- **J5. Pair brackets.** A single bracket on one side lets the joint rock around it. Put brackets
  on opposite faces (top + bottom, or both sides) of load-bearing joints.
- **J6. Align to a slot.** A butting member's center bore / end tap should line up with a slot
  on the receiving face so anchors and end screws work. Centered between two slots means no
  fastener can reach it. (That's why the crossbars sit on the upright's back slot.)
- **J7. Square ends matter.** End-butting joints (anchors, end-tap) only work if the cut end is
  square. Order precision-cut lengths or have them cut on a saw with a fence and a stop. Hand cuts
  leave gaps that let the joint rock.
- **J8. Minimum two fasteners per member per joint.** One bolt is a pivot.
- **J9. Avoid blind / in-slot connectors on any loaded joint.** Use them only for trim, panels and
  cable covers.

## 4. Wobble: stiffness checklist

Work down this list in order. Each step is cheaper and more effective than the next.

- **W1. Find the source first.** Push the frame and watch. Is the *desk* swaying (legs, motor
  stages), the *joint* rotating, or the *member* bending? Fix the actual source. Standing desk
  legs get looser as they extend, and extrusion can't fix that.
- **W2. Triangulate.** A rectangle can rack (lean into a parallelogram); a triangle cannot. A short
  45° diagonal brace (even 2020) at a corner is the single biggest stiffness gain available.
- **W3. Close the frame.** A post on its own is a cantilever. Two posts plus two crossbars make a
  portal that is far stiffer side-to-side. Tie loose ends into something.
- **W4. Tie parallel members** (P4). Vertical stiles bolted across both crossbars turn bar
  twist into push-pull, which is much stiffer.
- **W5. Upgrade joints** (J1–J5) before upgrading profiles.
- **W6. Shorten** spans and posts (P2, P3).
- **W7. Upsize** profiles last (P6).
- **W8. Preload holds stiffness.** A loose bolt gives a joint a dead band of free movement.
  Torque to spec and use locking hardware (F-section) so preload survives vibration.

## 5. Fasteners

- **F1. T-nut types:**
  - **Pre-assembly / slide-in** nuts (inserted from the profile end): strongest and cheapest.
    You must load them *before* closing the frame.
  - **Post-assembly / drop-in** (rotating) nuts can be added later. They are weaker and smaller.
  - **Spring-loaded / ball-spring** nuts stay where you put them. Use them on vertical members so
    nuts don't slide down while you assemble.
- **F2. Load spare nuts.** Before closing any frame, slide 2–4 extra pre-assembly nuts into
  every slot you might use later (cable clips, accessories, panel mounts).
- **F3. Torque:** Misumi reference for M5 into an HFS5 T-nut is **6.8 N·m**. Don't exceed it.
  Over-torque spreads the slot lips and *reduces* clamp. Use a torque driver if you have one.
  (80/20 publishes no general torque figure; use the vendor's sheet for the hardware you buy.)
- **F4. Lock it.** Misumi test at 6.8 N·m: plain nut releases at 5.2 N·m, resin-coated
  (HNTTZ5) at 6.5 (6.2 after 5 reuses), adhesive (HNTTV5) at 7.6. Use resin-coated / locking nuts or
  medium (blue) threadlocker on joints that carry monitors. Threadlocker needs primer to grip
  bare aluminum threads (end taps). Steel T-nuts don't need primer.
- **F5. Bolt length:** long enough for full nut engagement, short enough not to bottom out in
  the slot. A bottomed bolt feels tight but clamps nothing. Use the vendor's bracket kits or check the
  catalog length.
- **F6. Don't mix brands.** HFS5 nuts in an 80/20 slot (or vice versa) seat badly and slip.
- **F7. Re-torque** all load-bearing joints after about 1 week of use and after any move.

## 6. Assembly

- **A1.** Assemble on a flat surface. Snug all bolts first; do not final-tighten yet.
- **A2.** Square each rectangle by measuring **both diagonals**. Adjust until they're equal.
  Check corner squareness locally too.
- **A3.** Tighten progressively in a cross pattern, rechecking diagonals as you go.
- **A4.** Load spare T-nuts (F2) before closing any loop.
- **A5.** After assembly: load it (hang the monitors), then inspect each bracket for gaps,
  movement or deformation. Re-torque (F7).

## 7. Machining options

- **M1. End tap:** the profile's center bore can be tapped (M5 typical for HFS5 20-series) for
  an end-tap screw into a slot of the mating member. Misumi and 80/20 offer this as a cut-to-length
  option; it's cheap and accurate.
- **M2. Access hole:** anchors / end fasteners need a drilled access hole for the wrench in the
  receiving member. Order it machined, or use a drill jig.
- **M3. Counterbore (Misumi "reverse tap"):** a screw-only connection with no brackets and a
  clean look. Misumi publishes no load value for it, so pair it with a bracket where it carries load (J2).

## 8. Decision checklist (run for every extrusion joint)

1. What loads hit this joint, and in which directions? (Section 1)
2. Is it on the monitor load path? If yes, it is load-bearing. Use J2 (internal + external).
3. In which plane does the bending act? Brace in that plane (J1). Are the faces flush so a plate fits (J3)?
4. Does the butting member land on a slot (J6)? Are the ends square (J7)?
5. Bolt spacing as wide as the faces allow (J4)? Brackets paired (J5)? At least 2 fasteners (J8)?
6. Locking hardware and torque spec (F3, F4)?
7. If wobble is still possible, where would a triangle go (W2)?

---

## Decision log (this desk)

| ID | Decision | Rules | Status |
|---|---|---|---|
| D1 | Side rail **butts** upright front face, outer faces flush (T-joint), not lapped to the upright's inner face (lap gave only 40 mm bolt spread) | J1, J3, J4 | done |
| D2 | Side rail–upright joint: T-plate on flush outer faces + gusset under rail + end anchor. Real parts (D14): **HPTTD5** T-plate (110 x 80, 38 legs, 2.3 mm, 8 x M5; bar up the upright, 42 mm stem on the rail) + **HBLFSD5** 2-slot gusset (D15). The stem gives ~20 mm bolt spread along the rail, short of J4's ~80 mm: the gusset (J2) and end anchor carry the rest | J1, J2, J3, J4 | modelled (`HW-01/02` HPTTD5 outer, `HW-37/38` HPTTD5 inner (user 2026-10-29: double the T-plates; the inner faces of the upright and rail are flush too), `HW-07/08` HBLFSD5, replaced by HBLTDB5 in D23) |
| D3 | Crossbars sit on the upright's **back slot** (back faces flush). The end bore aligns with the slot, and the panel gets a flat mounting plane | J6, J3 | done |
| D4 | Monitors direct-VESA mount (no arms) on **vertical stiles tying both crossbars** | L4, P4, W4 | done |
| D6 | Crossbar ends: L-plate on flush back faces (lower bar leg up, clear of panel; upper bar leg down) + gusset under bar + end anchor. Real parts (D14): **HPTLD5** L-plate (80 x 80, 38 legs, 2.3 mm, 8 x M5) + **HBLFSN5** gusset | J2, J3, J5, J6 | modelled (`HW-03`–`06` HPTLD5, `HW-09`–`12` HBLFSN5) |
| D7 | Stiles sit **between** the crossbars (rest on the lower bar, L2; monitors 20 mm further back): 1-slot inside-corner bracket on **each side** of each stile end, in the frame plane so adapters and panel stay clear, + end anchors into the bar slot (J6). Real part (D14): **HBLFSN5** x 8, + 4 for the right stile (D19) | J5, J8 | modelled (`HW-13`–`20`, `HW-39`–`42` HBLFSN5) |
| D14 | **Buy, don't fabricate** (user, 2026-10-27): every joint uses catalog parts, no custom plates. Misumi HFS5: HPTTD5 x 4 (doubled 2026-10-29: outer and inner faces of each side-rail joint), HPTLD5 x 4, HBLFSN5 x 16 (12 + 4 for the right stile, D19; 20 wide, 30 mm legs, 5 mm, 2 x M5, 1176 N), HBLFSD5 x 2 (side rails, D15; replaced by black HBLTDB5, D23). The crossbar and stile gussets are 1-slot because those 2040 members show their 20 mm face to the gusset, so a 2-slot HBLFSD5 (40 wide) can't seat there; the 4040 side rails can take it. Order with `-SET` (CBM5 screws + HNTT5-5 T-nuts included). Drawings: `refs/misumi_brackets/p2259.pdf` | J2, J4, F1 | modelled |
| D8 | End anchors (crossbar ends, side rail ends): internal, not modelled. Order those ends tapped + access holes in the uprights | J2, M1, M2 | BOM |
| D10 | Privacy panel (desk stands mid-room, back faces the room) top = highest of upright tops and VESA adapter tops + `pnl_cover` (ports sit at/below the VESA mount, so monitors may show above it); upper crossbar top defaults flush with the highest adapter top, and a stile runs past a lowered bar up to its own adapter top. Panel held 12 mm off the back faces on 8 M5 standoffs into T-nuts (crossbars' upper slot, uprights' outer slot), so plates and bolt heads stay clear. Side panels add 6 more (`HW-47`-`52`, D22) | J6, F2 | modelled (`HW-21`–`28`, `parts/lib/HW-L11_Standoff_M5x12`) |
| D9 | Side rail to top support (2026-10-27): **through-bolts**. Each side has 4 M6 socket-head screws through the 4040 side rail and the top support's web, 8 in total. All 4 replace the frame's stock M6x14 leg screws and go into the leg columns' own threads, 2 per column (pitch ~2.47 in, so ~63 mm spread per leg pair; ~347 mm between the outer bolts). The channel-bar ends get no bolts. **Revised 2026-11-01 (user):** M6x55 with the head on the rail's outer face, Ø6.6 straight through both walls (was M6x20 seated on the inner wall through an Ø11 access counterbore). Simpler drilling, no seat to measure, and the head clamps across the whole profile; 55 - 40 - 3 = 12 mm thread engagement (stock screw: 11). A washer under the head (optional) brings it to ~10.4 mm if the leg thread proves shallow | J4, J8, M2 | modelled (`HW-29`–`36`, `parts/lib/HW-L10_M6x55_SHCS`; holes in `FRM-03L/R`); leg thread depth (≥ 12 mm) unverified |
| D15 | Side rails are **4040** (`side_t` = rail_l). Same 40x40 face as the upright, so the end butts its whole front face with outer faces flush (J3), and the gusset is the 2-slot **HBLFSD5** (`HW-07/08`, lib `HW-L04`, vendor STEP): 40 wide x 30 x 30 legs, 4.5 mm, 4 x CBM5-10 + HNTT5-5 on the 20 mm slot pitch, 1470 N vs 1176 N for the 1-slot HBLFSN5, and 4 bolts at 20 mm spacing across the joint instead of 2 (J4, J8). It sits **under the rail** (inside corner: rail underside / upright front face), centred on the shared 40 mm width. The top is blocked by the desktop, and the inner face is where the rail meets the top support. Underneath it clears the HPTTD5 by 1 mm, the panel standoff by 39 mm and the top support by 53 mm; the upright reaches 6 mm below its 30 mm leg (`up_below`) (scratch clearance 2026-10-28). The frame and channel bars get 20 mm narrower per side; the desktop and uprights don't move. The rail starts where the top-support web reaches full height (`side_front`), so the tapered end stays exposed | J3, J4, J5, J8, P3 | modelled; gusset now HBLTDB5 (D23) |
| D11 | Monitor aim: side (portrait) monitor toed in `m3_yaw` = 15 deg **about its inner front edge**, which lands at the main's left front edge at the same depth (`mon_front`), `mon_gap` apart. The side stile (`FRM-04`, occurrence `Stile_Side`) follows its VESA center (`m3_x`); its wedge adapter is `m3_off` (~66 mm at the center, print hollow). `m1_tilt` tilts **both** monitors about the main's VESA axis, so the edges stay matched (checked at 8 deg: 10 mm gap, no overlaps) | L4 | modelled |
| D12 | Speakers hang from their own back swivel mount (~3/4 up, `spk_mount_frac`) on a bracket bolted into the **upright front slot**: no shelf, no arm. Vertical slot = height freely adjustable (`spk_bot`), L2-friendly (the bracket can rest on a spare T-nut / stop below it). Swivel gives toe-in `spk_yaw` = min(`spk_aim` ~51 deg, `spk_yaw_max` 25 deg; left speaker 8.5 mm from the portrait monitor at 25) and tilt down `spk_tilt` = max(aim, 0): at `spk_bot` 8 in the tweeter is ~2 in below ear so tilt is 0; 12 in -> 2.6 deg down, 15 in -> 6.5 deg down. Load per bracket ~35 N at ~120 mm off the face: ~4 N*m on 2 M5 T-nuts, fine (F3/F4) | L2, L4, J8, F4 | modelled (`SPK-02`–`04`) |
| D13 | Screen height vs eyes: with `mon_clearance` 8 in and `eye_above_desk` 18 in (estimate), main top is ~6.5 in above eye, portrait top ~14 in. Trade-off between items-under-monitor space and neck angle | ergonomics | eye height measured 2026-10-29 (`eye_above_desk` = 46 in - `desk_h`); trade-off still open |
| D5 | Upright profile: 2040 (40 side front-to-back) vs 4040. Inputs below | P1, P3, P6 | decided in practice: built as 4040 (`FRM-01_Upright_4040`) |
| D16 | **Compliance restructure** (2026-10-28): part files linked into a skeleton-driven assembly (Rev A), 8020/V-slot variants retired. Every real part is its own file in `parts/` (hardware in `parts/lib/`), placed by joints from `skeleton/params.json`; the old single timeline (`legacy/desk_rails_legacy.solidcraft`) had ~680 features and rebuilt slowly on every early edit. Only HFS5 is bought, and the 8020/V-slot config rows were broken (their body transfers named HFS5 bodies), so keeping them cost upkeep for nothing. Plan: `docs/COMPLIANCE_PLAN.md` (removed 2026-10-31, in git history) | — | done |
| D17 | **62x32 layout variant** (user, 2026-10-31: smaller room footprint, desk ~62 in wide, >= 30 in deep): `desk_rails_62x32.solidcraft`, built by `tools/build_variant.py desk_62x32` from `variants/desk_62x32/` (skeleton overrides `desk_w` 62 in, `desk_d` 32 in); the 74x26 main design is unchanged. The hung speakers (D12) can't fit inside a 62 in footprint: the portrait monitor's outer edge is at x = -718 of +/-787. So the R-40Ms lie on their side, tweeter end outboard, on low 8 deg wedges (`SPK-05`, product TBD) under the side screens, toed in toward the Eye; `spk_laid.solve` puts them mid-window between the mouse pad (front) and the side screen bottom edge (back). A 75 mm IsoAcoustics Aperta300 or a 2 in Auralex MoPAD-XL is too tall: the left speaker's top hits the portrait screen wherever the right one clears the mouse pad. Laptop tray raised (`lap_tray_z`, solved) so tray, laptop and mount arm clear the right speaker | L2, L4 | modelled (variant) |
| D18 | **Lower crossbar dropped 40 mm** (user, 2026-11-01): `bar1_gap` 25 -> 65 mm, bar centre 158 -> 118 mm above the desktop, so the bar top sits 65 mm under the monitors. The space above the bar is for the user's 3D-printed accessories (USB hub housing, macro pad) on the bar's front slots. Chosen over a third crossbar: the lower bar already exists for this, a third bar would sit only ~40-60 mm from it and add a 2040, 2 HPTLD5, 2 HBLFSN5 and end anchors for no extra usable face. The stiles lengthen with it (L = bar2_z - bar1_z - rail_l); monitors don't move | L2, P4 | modelled |
| D19 | **Right stile + laptop arm on it** (user, 2026-11-01): a third FRM-04 stile `Stile_Right` at `stile_r_x` = -`m3_x` (mirror of the side stile), same joint as D7 (`HW-39`-`42` HBLFSN5). The laptop mount (LAP-01, user-built jig placeholder) moves from a C-clamp on the lower crossbar top to a base plate on the right stile's front slot (T-nuts, height freely adjustable); a riser drops past the crossbar front face to the arm, which reaches `lap_reach` toward the user and `lap_arm_dx` sideways to the tray pivot. This decouples the laptop from the crossbar height (D18) | J5, J8, L2, D14 | modelled |
| D20 | **Knee braces under the side rails** (user, 2026-11-01): fore-aft stiffness of the top frame came only from the two upright-to-rail moment joints (the crossbars run side to side). Each upright now runs `brace_leg` below the rail (`up_below` = rail_l + max(plate_ext, brace_leg)), and a 45 deg **HFS5-2040** brace (`FRM-06`, 40 across X, flush with the upright and rail faces, both ends mitred: order `HFS5-2040-L-xT45-xT45`, L = brace_leg*sqrt(2) ~212 mm) runs from the upright front face up to the rail underside, in the rail's plane, outboard of the top-support web, so it clears the legs. That turns the moment joint into a triangle. The user asked for flat joining plates on both side faces, but Misumi has no 45 deg flat joining plate (research 2026-11-01, `refs/misumi_brackets/HBL45T5/README.md`), so each end gets an **HBL45TD5** 2-slot 45 deg bracket inside the triangle (34 wide, 4 x M5, 1470 N; lib `HW-L05`, modelled from the HBL45TS5 STEP section): `HW-43`-`46`. Its 82 mm base pushed `brace_leg` from ~120 to 150 mm, so it clears the HBLFSD5 gusset by 9.6 mm and the two brackets clear each other by ~9 mm. A 2040 rather than a 2020 (user choice) puts 2 slots on the brace's inner face for the 2-slot bracket (J8, J4). Alternatives rejected: custom flat plates (D14), HPTGS5 steel strap brace (a strap, not a stiff member). Checks (near_check 2026-11-01): legs clear; the brace's inner face is flush with the rail's, so it bears on the top-support web's outer face where the web runs 10.8 mm below the rail (same plane the rail bolts to, designed contact) | W2, J4, J8, D14 | modelled |
| D21 | **Hanger plates on the top-support flanges** (user, 2026-11-01, from `side-rail-recommended-changes.pdf` Change 1): a `hang_t` x `hang_w` x `hang_len` (5 x 80 x 530) zinc-plated steel flat bar per side (`FRM-07L/R`) sits on the flange under the desktop, flush with the rail's outer face, rear end flush with the flange's rear end (y = -261.7 .. 268.3). The rail hangs from it by 10 x M5x12 countersunk (ISO 10642) screws into drop-in HNTT5-5 T-nuts in both top slots, pairs at y = -200, -20, 130, 195, 255 (3 of 5 in the rear half, where the load hangs), so the rail's weight bears on the slot lips instead of friction at the leg threads, spread over ~500 mm instead of the 350 mm between the leg bolts. 4 x M5x16 countersunk + nyloc tie it through the flange at y = +/-`hang_scr_y2` (40) and +/-`hang_scr_y` (250) on the mid-flange line (DSK-02 drilled 5.5 mm, user drilling) so it can't tip over the web corner. Those stations clear the flange's stock desktop-screw slots (user measurement 2026-11-01: 6 x 12 mm, rounded ends, long axis front to back, slot edge 8 mm from the flange inner edge and 36 mm from each end, third slot at mid-length: centres x = 25.8 mm inboard of the web face, y = 0, +/-226.3; `ts_ds_*`), now modelled in DSK-02, and the plate has 7 x 13 clearance slots over them (`hang_ds_clr`). The PDF's y = 0 and the first-pass +/-225 stations sat on those screws. `frame_top` = desk_h - desk_t - hang_t: the measured desktop top stays the datum, so the frame (legs, top supports, rails, uprights, PC strap) sits 5 mm lower and the desktop rests on the plates; uprights grow 5 mm (L = up_below + hang_t + desk_t + up_above), and the panel and everything on the desktop don't move. Keep the M6x55s (D9) with a hardened washer under each head and re-torque after a week. The plate goes to the vendor as a configurable plate with countersinks (vendor machining, D14). Checked against our model, which wins where they differ: flange 36.83 mm (`ts_w`, PDF 36.8), legs 287.7 c-c, housings y 103.5-184.2, rail front -230.2, upright y 360.2 all match. **Dropped:** the PDF's optional 4th flange screw at y = -80 lands on the front-inner channel bar (y 76.2-95.8 under the flange; the PDF omitted the channel bars). The y = 0 crossbeam worry doesn't apply: the channel bars are at the legs and y = 0 is clear. `FRM-07_gen.py` asserts every station against the skeleton (plate ends, rail front end, channel bars + housings, flange width). The Apex guide step 3 puts 14 x 7/8 in wood screws through the frame into the desktop, 3 per top support and 8 into the channel bars: the desktop now sits 5 mm above the channel bars, so those 8 points get 5 mm spacers or washers (user, 2026-11-01; not modelled) and every desktop screw goes ~5 mm longer (~1-1/8 in). **Open before ordering:** (1) `ds_head_r` (5 mm) is an estimate of the wood-screw head; (2) confirm M5x12 against the HNTT5-5 valid screw range (Misumi pairs CBM5-10 with the 4.5 mm HBLFSD5: 5.5 mm below the plate; M5x12 csk gives 7.0); (3) check the real flange for weld bumps or bosses. Change 2 of the same PDF (diagonal brace + plates on both faces) was already in place as D20 (2040, `brace_leg` 150, HBL45TD5) and D14 (HPTTD5 on both faces); our values win over its 2020 / 120 mm / 803 mm upright | W2, W8, J4, D9, D14 | modelled |
| D22 | **Visual phase V1: felt privacy panel + side panels** (user, 2026-11-02). The privacy panel (FRM-05) becomes 12 mm dark grey PET felt board (`pnl_t`; Kirei / AcoustiGuard 12 mm, or Felt Right 9 mm, `refs/visual_black_felt/`; 9 mm likely waves between standoffs, so 12) with its two top corners rounded `pnl_r` = 50 mm. Each upright gets a felt side panel (FRM-08, corner return) on its outer face, 12 mm off on 3 standoffs (HW-47..52, HW-L11) in the outer face's front slot, clear of the HPTTD5 bar (z 551-669) whose CBM5 heads stand 7.3 mm proud (`docs/visual_joint_review.md`), and clear of the crossbar end-anchor access holes. It runs from the upright front face to the privacy panel's front face (D = rail_l + pnl_back_gap = 52 mm) and stops `pnl_r` below the panel top, where the corner arc turns vertical. `pnl_side` = -(pnl_back_gap + pnl_t) widens the privacy panel 24 mm per side so it runs out over the side panels' back edges (user 2026-11-02: the panel covers the side panels, so the rounded corner reads cleanly from behind; first pass had the side panels wrapping the panel's ends): no gap at the corner. `pnl_cover` = pnl_r + 15 mm keeps the side panels covering the upright tops by 15 mm. Felt pulls through under a screw head: fix both panels with button heads on >= 25 mm washers (black). A flush side panel only above/below the plate was rejected: it leaves bare plate at desk height | F2, D10 | modelled |
| D23 | **Visual phase V2: black frame + end caps** (user, 2026-11-02). Extrusion ordered black anodized **HFSB5-2040/4040** (same section values as HFS5, same LTP/RTP tapping and LAT45/RAT45 mitre codes; e.g. `HFSB5-2040-212-LAT45-RAT45`; black 2040 lead ~4 weeks; cut and mitred faces stay bare Al). Gussets **HBLFSNB5** (black HBLFSN5, same 1176 N). No black HPTTD5 / HPTLD5 / HBL45TD5 exists: the user paints or powder-coats them black. Hanger plates FRM-07 stay 5 mm flat bar, black powder coat by a local shop (Misumi plates stop at 500 mm). Standoffs black (Misumi black-anodized round standoff or Lyn-Tron -14), M6x55 already black oxide; bracket screws HCBMTB5 black where visible. HBLFSD5 (no black version) replaced by black **HBLTDB5** (`HW-07/08`, lib `HW-L06`, vendor STEP `refs/misumi_brackets/HBLTDB5/`): same 1470 N and vendor frame, 34 wide x 35 x 35 x 5, no tabs, holes 25 from the corner; near_check 2026-11-02: > 5 mm from everything incl. the HBL45TD5 (was 9.6 mm with the 30 mm legs). End caps **HFC5-4040-B** (black PA, 3 mm, press fit) on the 6 free 4040 ends (HW-53..58: upright tops and bottoms, side-rail front ends); every other end is a tapped joint face or a 45 deg mitre (no cap fits). Black slot covers HSCA5-B on unused slot runs: BOM item, not modelled. Sources: `refs/visual_black_felt/README.md`, `docs/visual_joint_review.md` | D14, F1 | modelled |
| D24 | **Lower-crossbar console** (user, 2026-11-02): one 344 x 124 mm 3D-printed console centred under the main monitor (`con_x` 0), with the phone on its own stand to its left, top line `con_top` above the lower bar. One face raked 20 deg back toward the eye (24 deg below level from the skeleton Eye); every device flush in it: Scarlett Solo + ABFCRTTW 7-port hub (ACC-02), KVM key (MX switch, 3.5 mm TRS panel jack to the KVM under the desk) in a column beside the duckyPad Pro in the user's standard case (ACC-05, from their STEP); the USB-C fingerprint dongle plugs into the hub's rightmost USB-C port (user 2026-11-02: the first pass's separate control bay ACC-04 wasted space, retired). Right-handed order: most-used right of centre. Look borrowed from the duckyPad case: charcoal body, parting groove level with the bar top, light grey touch points and inlay line (ACC-06). Printed as 2 bays with 1 mm seams, d4 dowels at the seams; each hangs on a 6 mm spine by M5 button heads into HNTT5-5 drop-in T-nuts in the bar's front slots, so it slides along the bar. Cables leave at the back, over the bar top or below its bottom, and run behind the rails. Desk grommet ACC-01 at x 0, `grom_y` 144, midway between the rear channel bars (18 mm clear of each; moved forward from y 270 for shorter keyboard cables, user 2026-11-02), drilled by the user. Layout in `parts/src/ACC_layout.py` (shared by the bay and device generators). Device sizes marked MEASURE in ACC_layout are estimates. The phone left the console (user 2026-11-02: changes phones and cases, wants space around it and not flush): ACC-07 is its own stand on the bar at console x -330, a spine with 2 x M5 + HNTT5-5, a neck and a d66 cup holding the Apple MagSafe puck 55 mm in front of the bar, raked 20 deg; the phone (landscape, StandBy) hangs on the magnet with nothing around it; ACC-03 retired | J6, F2, D14 | modelled |
| D25 | **Webcam on the main monitor** (2026-11-06, default pending the user's pick of mount spot): Insta360 Link 2 Pro (MON-03) on its own magnetic clip, centred on the M32U top edge (`m1_x`, `mon_front`, top = desk_h + mon_clearance + m1_h). Nothing to buy; best eye contact of the five spots surveyed (straight ahead, lens ~11 deg above the Eye vs ~17 deg above the screen centre); shortest cable to the ACC-02 hub. The clip's rear leg rests on the 18 mm panel edge (`m32u_slab_t`, MEASURE), 38 mm down, well above the rear housing (106 mm). Alternatives: an HFSB5-2020 post on Crossbar_High behind the monitor (doesn't move with the monitor, but the lens clears the bezel sightline by only ~20 mm and the M5-to-1/4-20 stud isn't confirmed as a catalog part); a T-nut + stud on the right upright (48 deg off axis); the side monitor top or Crossbar_Low (poor angles). Placement assumes `m1_tilt` = 0. Model: Sketchfab Link 2 mesh (CC BY, bswlife) scaled to the 58.9 mm spec height, `refs/insta360_link2pro/README.md` | D14 | modelled |

### D5 inputs: 2040 vs 4040 uprights

Current load: 32in main (about 6.5 kg) + 27in portrait (about 4.5 kg), direct VESA, about 60–75 mm in front
of the uprights, so about 4 N·m per upright. Upright about 640 mm from the side rail joint to the top.

| | 2040 (40 side Y) | 4040 |
|---|---|---|
| Lean at top under monitor load | ~0.2 mm | ~0.1 mm |
| Twist resistance | poor (but the crossbars + stiles carry the twist, P4) | good |
| Face for side-rail plate (J3/J4) | 40 mm (outer face) | 40 mm |
| Faces with 2 slots | 2 (outer and inner) | 4 |
| Matches butting members | side rail end (20 wide) = front face exactly | front face 40 wide, side rail sits on outer slot |
| Mass / cost | lower | about 45% more |
| Future-proof (overhead bar, shelf, heavier monitors) | less | more |

Both are far below any wobble you'd see. The joints (D2) and the desk itself (W1) decide the
real feel. Choose 4040 for future loads, more slots or the look; choose 2040 for slim and cheap.

### Structural audit (2026-10-26, `tools/audit.py`, estimated masses)

Masses: frame ~52 kg (DeskHaus ships the Apex Pro 4 in 60 + 62 lb boxes), desktop ~28 kg (IKEA Karlby package 28.9-29.7 kg), monitors 6.5 + 4.5 kg, 1/4in plywood panel ~7 kg (now 12 mm PET felt, D22: lighter; not re-run). Heavier frame/desktop **raises** the tip force (they sit centered); heavier monitors/panel lower it. Worst mix tested (light base, heavy monitors, acrylic panel): ~32 lbf back-tip standing.
Rerun after weighing: `python tools/check.py` (writes `build/report.json`, then runs the audit), or `python tools/audit.py build/report.json` (see the script's docstring).

| Check | Result | Verdict |
|---|---|---|
| Total / riding on lift | ~107 kg / ~75 kg | fine (check frame label rating) |
| Center of mass | ~90 mm (3.5in) behind frame center, ~260 mm inside rear foot ends | statically stable |
| Push at upright top to tip **backward** | ~150 N (33 lbf) standing, ~200 N (45 lbf) seated; worst case ~124 N (28 lbf) | **weakest case**: rails + panel sit behind the foot ends. Wall behind or an anti-tip strap fixes it |
| Push to tip forward / sideways | ~250 / ~490 N standing | fine |
| Leg split | rear legs ~95% of lift load | fine for strength; keep heavy desk items forward |
| Crossbar sag | 3.0 mm pinned (upper bound), ~1.5 mm with bolted ends; both bars sag together, monitors drop, don't tilt | at Misumi L/1000 (1.8 mm), acceptable |
| T-joint static moment | ~0 N*m (panel behind balances monitors in front) | fine; only dynamic loads |
| Side rail to top support (D9) | ~10 N*m per side, ~100 N bolt pull at 100 mm spread | fine if 2+ bolts, spread wide; modelled as D9 + D21 |
| Upright lean | 0.1-0.2 mm | fine (D5 either way) |

Real-world limit is wobble at standing height (W1), not strength: masses sit high and rear-heavy on the legs.
Biggest stiffness wins: bolt the panel firmly so it acts as a shear wall (W2/W3), and the 45 deg
knee brace between each side rail and the upright below the desk (W2, fore-aft; done, D20).

---

## Sources

- [Misumi HFS5 catalog p2239: section properties](https://us.misumi-ec.com/pdf/fa/2010/p2239.pdf)
- [Misumi load capacity guideline p2433: 1/1000 rule, E](https://us.misumi-ec.com/pdf/fa/2010/p2433.pdf)
- [Misumi extrusion parts selection: brackets vs blind vs screw joints](https://th.misumi-ec.com/en/pdf/fa/2014/p2_513_519_521_523_525.pdf)
- [Misumi HNTT5 T-nut: torque 6.8 N·m, release torques](https://us.misumi-ec.com/vona2/detail/110302246150/?HissuCode=HNTT5-4)
- [Misumi HBLFSN5 bracket](https://misumi.partcommunity.com/3d-cad-models/hblfsn5-hblfsn5-4-hblfsnb5-hblfsnm5-hblfsnk5-hblfsne5-brackets-hfs5-reversal-brackets-with-tab-misumi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),
  [HBLFSD5](https://misumi.partcommunity.com/3d-cad-models/hblfsd5-brackets-hfs5-reversal-brackets-with-tab-2-slots-misumi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),
  [HBLBCB5 blind](https://misumi.partcommunity.com/3d-cad-models/hblbcb5-shblbcb5-corner-blind-brackets-hfs5-20mm-square-three-way-type-misumi/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)
- [80/20: internal vs external fasteners](https://8020.net/blog/8020-t-slot-framing-fasteners-internal-vs-external.html)
- [Industrial Profile Systems: joint design and assembly](https://www.industrialprofile.com/aluminum-extrusion-joints-design-and-assembly-considerations/)
- [ToolGuyd: anchors, end fasteners, brackets](https://toolguyd.com/hardware-for-connecting-t-slot-aluminum-anchors-end-fasteners-brackets/)
- [Engineers Who Van Life: fastener lessons](https://engineerswhovanlife.com/fasteners-80-20-van-building/)
- [Aluminum Compo: internal anchor FAQ](https://aluminumcompo.com/internal-anchor-connectors-faq/)
- [Clinalu: assembling square frames](https://clinalu.com/how-to-assemble-t-slot-aluminum-framing-without-alignment-problems/)
- [Thread-locking compound (aluminum priming)](https://en.wikipedia.org/wiki/Thread-locking_compound)
- Forum load reports (unverified):
  [Ford Transit forum](https://www.fordtransitusaforum.com/threads/8020-connector-strength-reviewed.97394/),
  [Chief Delphi](https://www.chiefdelphi.com/t/strongest-80-20-fastener/76342),
  [CNCZone](https://www.cnczone.com/forums/diy-cnc-router-table-machines/288122-cnc-forum.html)
