msetsma/desk-rail-system/(commit log)

2026-10-27 feat: parametric desk rail system with modesty panel
    SolidCraft model of the Apex Pro 4-leg frame with a 20-series extrusion
    rail system, generated from tools/gen_desk.py.
    - Rear 4040 uprights, short stubs below the desk ending at the side-rail
    T-plate; the panel hangs free below them.
    - 2040 crossbars: the lower bar sits in the gap under the monitors for
    mounting accessories; the upper bar top is flush with the highest VESA
    adapter top.
    - Stiles sit between the crossbars (monitors 20 mm further back), with
    in-plane corner brackets and tapped ends.
    - Privacy panel for a mid-room desk: top just above the adapter tops so
    ports and cables stay hidden; 8 standoffs.
    - Klipsch R-40M spe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
    [8020_20-2040.dxf, 8020_20-4040.dxf, misumi_hfs5_2040.dxf, misumi_hfs5_4040.dxf, openbuilds_vslot_2040.dxf, openbuilds_vslot_4040.dxf]
2026-10-27 feat: add PC hanger, input devices, and assembly structure
    Built in a SolidCraft agent session directly in the design file:
    - PC-00: Fractal North on a 6in x 1/2in strap with walnut slat front
    (params pc_leg_gap, strap_w)
    - INP-00: 16.5in mouse pad, Razer DeathAdder V3, ErgoDox EZ halves
    (params kb_gap, pad_kb_gap, kb_front_gap, pad_front_gap)
    - Bodies regrouped into DSK/FRM/HW/MON/SPK/PC/INP/REF assemblies with
    part-number names and rigid joints; DSK grounded
2026-10-27 refactor: make desk_rails.solidcraft the source of truth
    Retire the generator (tools/gen_desk.py, tools/joints.py, desk_rails.json):
    the design now carries work done directly in SolidCraft (assemblies, PC
    hanger, input devices) that the script never had. check.py now reads a
    report from the saved design instead of regenerating and overwriting it.
    README documents the assembly structure.
2026-10-27 feat: real ErgoDox EZ outline from ZSA 1:1 printout
    Replace the estimated 210x160 mm keyboard boxes with the case outline
    traced from ZSA's official 1:1 PDF (scale verified against its 10 cm
    ruler): 202.3 x 176.3 mm per half incl. thumb cluster, 15 mm case plus a
    tapered 15 mm keycap layer (30 mm total per ZSA spec). Outlines kept as
    DXF in refs/ergodox_ez. Mouse dims confirmed against Razer spec.
2026-10-27 feat: rough DeathAdder V3 Pro shape, keyboard 40 mm deeper
    Mouse box replaced by the intersection of plan, side and front
    profiles at Razer's 128x68x44 mm: rear hump, thumb-side waist, crowned
    top. kb_front_gap 40 -> 80 mm.
2026-10-27 feat: real Razer DeathAdder V3 Pro CAD
    Replace the hand-drawn mouse with the vendor STEP (10 bodies, renamed
    Mouse_DAV3Pro_*), rigid-jointed to the mouse pad's top-face centre so it
    still follows pad_x/pad_y. check.py ignores the model's internal gaps.
2026-10-27 feat: Misumi catalog connectors (HPTTD5, HPTLD5, HBLFSN5)
    Plates and gussets resized to catalog dimensions with their bolt holes
    (8 x 5.5 per plate, 2 x 5.3 per gusset). Mouse scroll wheel and base
    simplified so the headless rebuild stays fast. Guide D14: buy, don't
    fabricate. BOM labels name the Misumi -SET parts.
2026-10-27 feat: real Misumi joint hardware (HPTTD5, HPTLD5, HBLFSN5)
    Replace the 20 orange envelope bodies with vendor STEP geometry, placed by
    parametric moves that reuse the envelopes' expressions. Bodies keep their
    names plus a part-number suffix; colors follow the real finish (zinc-plated
    steel plates, as-cast aluminium gussets). Vendor kits are stripped to the
    part body (*_plate.stp / *_bracket.stp) to keep screws, nuts and their
    rigid joints out of the model.
2026-10-27 feat: detailed Klipsch R-40M speaker models
    No vendor CAD exists for the R-40M, so model it from Klipsch product
    photos (refs/klipsch_r40m): wood-grain cabinet, recessed baffle,
    Tractrix-style horn with tweeter, copper logo, spun-copper woofer with
    trim ring, surround and dust cap, rear port, binding posts and screws.
    Built once in the speaker's local frame and placed per side with the
    existing spk_tilt / spk_yaw / spk_p* expressions, so mounts and aiming
    still drive it; the old box bodies are removed.
2026-10-28 feat: pre-compliance milestone (4040 side rails, through-bolts, Apex Pro top supports)
    Adds AGENTS.md/PROJECT.md rules, cad-best-practices skill, compliance plan
    and Apex Pro reference photos.
2026-10-28 feat: Rev A compliant structure (parts linked, skeleton, metadata)
    Rebuild desk_rails.solidcraft as an assembly of 29 linked part files placed by
    planar joints from skeleton/params.json (30 features, was 600; 0 warnings).
    Parts build from parts/src scripts; hardware from the parts/lib library.
    Materials, properties, named views and display rows applied by
    tools/assembly_finish.py. Frame recoloured DeskHaus Silver.
    Verified: bbox regression 104/104 legacy bodies, full interference check,
    parameter sweep (desk_w 70/78 in, desk_d 30 in, desk_h 45 in) with 0 errors.
    Legacy model archived in legacy/.
2026-10-28 perf: drill side rails via box blank + intersect; parallel sweep tool
    Side-rail bolt holes were one solid.hole on the HFS5 DXF profile (~46 s
    boolean, re-paid on every insert). Now cut into a plain box blank and
    intersected once: 55 s -> 7.5 s per rail, geometry within 0.0003 %.
    Assembly build 2m15s -> 53s; tools/sweep.py runs cases in parallel on
    private part copies (17 min -> 1m44s).
    AGENTS.md/PROJECT.md: rules and quirks from the timing audit.
2026-10-28 feat: real-product parts, 4 leg bolts per side, frozen part links
    - Apex Pro base from DeskHaus docs: inverted 3-stage Jiecang column (80x50),
    foot with glides, bent-steel channel bars; leg_x/leg_y/foot_h/leg_inset updated.
    - Side rails and top supports: only the 4 leg-screw bolts per side (8 total).
    - Fractal North (Charcoal, walnut front), Gigabyte M32U (VESA offset
    m1_vesa_dz), ErgoDox EZ with light grey SA keycaps.
    - PC strap rebuilt as one parametric bent profile (no coordinate edge picks).
    - regen_parts.py builds each part from its script, freezes it to a STEP-based
    part file (history kept in build/parts_hist), rebuilds only changed parts in
    parallel and prints targeted update_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
2026-10-28 feat: HBLFSD5 side-rail gussets, leg taper fix, strap on case body
    - HW-L04 HBLFSD5 (Misumi vendor CAD) replaces HBLFSN5 at both side-rail /
    upright joints (HW-07/08): under the rail, inside corner at the upright face.
    - DSK-04 leg stages narrow toward the top (widest stage on the foot);
    DSK-05 foot pockets sized for the bottom stage.
    - PC strap bears on the case body; new pc_foot_h (19 mm) lets the feet hang.
    - ErgoDox case black (user's own light grey SA keycaps).
2026-10-28 docs: build assembly straight to its final path
2026-10-29 feat: laptop jig + MacBook, Mirra 2 chair, measured desk frame
    - LAP-00: user-built laptop mount on the lower crossbar (LAP-01), tilting
    tray (LAP-03) and MacBook Pro 14 (LAP-02): deck 20 deg front-down, screen
    at the monitor tilt, rounded hinge; placed 36.5 deg / 800 mm by a
    sightline search (no clash, speakers and monitors unblocked)
    - CHR-00: Herman Miller Mirra 2 (Studio White / Fog) converted from the
    vendor 3D DWG (LibreDWG + tools/mesh_step.py), seat down, arms at frame level
    - tools/sightlines.py: ray-cast sightlines + oriented-box laptop fit check
    - Measured desk: 26.5 in top, top support, channel bars, leg stages and
    spacing, foot glides; eye height from 46 in floor-to-ey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
2026-10-29 chore: tighten saved view distances ~25%
2026-10-29 feat: component display rows and matching named views
    Rows Rails only, Desk only, Desk + rails, No chair; views Rails,
    RailsBack, Desk, DeskRails framed for them.
2026-10-31 feat: 62x32 desk variant with laid speakers on wedges
    New layout variant desk_rails_62x32.solidcraft (smaller room footprint),
    built by tools/build_variant.py from variants/desk_62x32; the 74x26 main
    design and its parts are unchanged (D17).
    - R-40Ms lie on their side, tweeters outboard, on low 8 deg wedges
    (SPK-05, product TBD) under the side screens, toed in 30 deg.
    tools/spk_laid.py solves depth (mid-window between mouse pad and side
    screen edge) and the placement frame vectors.
    - Laptop tray raised to 305 mm so tray, laptop and arm clear the right
    speaker and hide nothing from the Eye.
    - skeleton_values takes a params path; build_script takes a part
    resolver; sightlines models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
2026-10-31 chore: remove stale renders, retired profiles, legacy model and compliance plan
    Renders predated the compliance rebuild; 8020/V-slot DXFs retired in D16; legacy
    model and COMPLIANCE_PLAN.md are history (recoverable from git). check.py --renders
    now writes to build/renders/.
    [8020_20-2040.dxf, 8020_20-4040.dxf, openbuilds_vslot_2040.dxf, openbuilds_vslot_4040.dxf]
2026-11-01 feat: M6x55 side-rail bolts with heads on the rail outer face
    Replaces the M6x20 screws seated on the 4040 inner wall through an 11 mm
    access counterbore (D9 revised). Rails now get a 6.6 mm hole straight
    through; sr_seat_t and sr_access_d removed; leg tap depth follows
    sb_len - side_t - ts_t (12 mm).
2026-11-01 docs: don't run assembly and variant builds in parallel
2026-11-01 fix: regen picks up generator-created parts; per-design finish scratch files
    regen_parts re-reads the part list after running generators and warns about
    frozen parts left without a script. assembly_finish names its eval/finish
    scratch files after the design, so build_assembly and build_variant can run
    in parallel. AGENTS/PROJECT: lessons from the M6x55 change (cross-file edit
    scripts, CRLF matches, retire skeleton params lazily).
2026-11-01 refactor: CAD best-practice cleanup from rules review
    - MON-01, LAP-02, PC-01/02: pick points computed from params; skeleton is the
    single source for monitor and MacBook sizes (local duplicates removed)
    - SPK-01: new generator; face details follow spk_d/spk_h; logo outlines in refs/
    - Generators use repo-relative ROOT
    - Lib parts carry Source metadata
    - assembly_finish: view targets from skeleton values (correct for variants),
    placement joints grouped into their link folders, Source in properties
    - audit: laptop + HBLFSD5 groups, laptop load on the right stile, walnut desktop
    - bom: LAP-01 and HBLFSD5 fasteners
    Regression: every rebuilt body matches its previous bbox/volume.
2026-11-01 feat: drop lower crossbar 40 mm, add right stile with the laptop arm on it
    - bar1_gap 25 -> 65 mm: room above the lower bar for printed accessories (D18)
    - Stile_Right at stile_r_x = -m3_x with 4 HBLFSN5 gussets HW-39..42 (D19)
    - LAP-01 moves from a crossbar clamp to a base plate on the right stile's front
    slot (lap_mount_z, lap_reach from stile_front, lap_arm_dx)
    - spk_laid: LAP-01 envelope read from its generator; stiles are obstacles
    - sightlines: Stile_Side and Stile_Right boxes
    - near_check: per-design scratch files (parallel main + variant checks)
    - skeleton: 15 unused params removed, MEASURE tags on unsourced dimensions
    - build_assembly docstrings; README/BOM/guide/AGENTS/PROJECT up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
2026-11-01 feat: 45 deg 2040 knee braces under the side rails with HBL45TD5 brackets (D20)
    Uprights extend brace_leg (150 mm) below the rail; FRM-06 HFS5-2040 brace, 40 across X,
    mitred both ends, in the rail plane outboard of the top-support web. Misumi has no flat
    45 deg joining plate, so each end gets an HBL45TD5 2-slot bracket (new lib HW-L05,
    HW-43..46), modelled from the HBL45TS5 vendor STEP section (refs/, gitignored).
2026-11-01 feat: hanger plates on the top-support flanges carry the side rails on T-nuts (D21)
    5x80x530 zinc-plated steel plate per side (FRM-07L/R) under the desktop, flush with the rail
    outer face; 10 x M5 csk into HNTT5-5 T-nuts in the rail top slots, 3 x M5 csk + nyloc through
    the flange (DSK-02 drilled). New skeleton params hang_t/hang_w/hang_len/hang_scr_y;
    frame_top = desk_h - desk_t - hang_t, so the measured desktop top stays the datum and the
    uprights grow 5 mm. The generator checks every hole station against the skeleton. The review's
    optional y=-80 flange screw was dropped because it lands on a channel bar. Change 2 of the review
    was already modelled (D20 + D14).
2026-11-02 feat: measured desktop-screw slots in the top supports; hanger plate clears them (D21)
    User-measured 6x12 slots (long axis front-back, edge 8 mm from the flange inner edge and 36 mm
    from each end, one at mid-length) modelled in DSK-02 as skeleton params ts_ds_*. FRM-07 gets
    7x13 clearance slots over them. The flange screws move from 0/+-225 (on the desktop screws) to
    +-40/+-250, 4 per side. The generator now also checks the flange screws against the slots.
2026-11-02 docs: SolidCraft improvements for agent-driven CAD
2026-11-02 feat: dark grey felt privacy panel with R50 top corners and side panels on the uprights (D22)
    12 mm PET felt (pnl_t), pnl_r 50 mm corner arcs drawn from skeleton expressions,
    FRM-08 side panels on 12 mm standoffs (HW-47..52) clear of the HPTTD5 screw heads,
    pnl_side -12 mm so the panel butts the side panels with no gap, pnl_cover = pnl_r + 15.
    Adds PET felt / PA6 materials, the joint visibility review and black/felt research.
2026-11-02 feat: black HFSB5 extrusion, black hardware and HFC5-4040-B end caps (D23)
    Extrusion, HBLFSNB5 gussets, standoffs black; joining plates, 45 deg brackets and
    hanger plates modelled black (user paint / local powder coat). HBLTDB5 replaces
    HBLFSD5 under the side rails (no black HBLFSD5). Six end caps on the free 4040 ends.
    near_check: no overlaps.
2026-11-02 feat: privacy panel covers the side panels' back edges (D22)
    pnl_side -(pnl_back_gap + pnl_t): the panel runs out over the side panels, which
    now butt its front face (D 52 mm), so the rounded corner caps them from behind.
2026-11-02 feat: lower-crossbar console with flush devices and desk grommet (D24)
    - ACC-02..05: four 3D-printed bays (audio, phone, control, duckyPad) with one
    20 deg raked face, hung on M5 + HNTT5-5 T-nuts in the lower bar's front slots
    - ACC-06 light grey inlay line; ACC-01 printed grommet, 60 mm hole in DSK-01
    - ACC-11..17 device refs: Scarlett Solo, ABFCRTTW hub, iPhone 16 Pro Max,
    MagSafe puck, fingerprint dongle, duckyPad Pro (user's case STEP), KVM key
    - Shared layout in parts/src/ACC_layout.py; skeleton con_x, con_top, grom_y, grom_d
    - Assembly group ACC-00, display rows, near_check mating rules
    [DPP Case - Bottom.step, DPP Case - Bottom.stl, DPP Case - Button.step, DPP Case - Top.step, DPP Case - Top.stl]
2026-11-02 feat: compact console, fingerprint in the hub, grommet forward (D24)
    - Retire ACC-04 control bay: console 594 -> 524 mm, centred under the
    main monitor (con_x 0)
    - KVM key (MX + TRS jack) moves to a column beside the duckyPad in ACC-05
    - Fingerprint dongle plugs into the hub's rightmost USB-C port (no pocket)
    - Grommet moves to grom_y 144, between the rear channel bars
2026-11-02 feat: phone on its own MagSafe stand, console down to two bays (D24)
    - ACC-07 phone stand: spine on the lower bar (2 x M5 + HNTT5-5), neck and a
    cup holding the MagSafe puck; any phone or case hangs on the magnet
    - Retire ACC-03 phone bay: console 524 -> 344 mm (audio + duckyPad/KVM)
2026-11-04 docs: audit README, BOM, lib README, build spec and guide against D20-D24
2026-11-05 feat: rebuild desk_62x32 variant with D20-D24 (brace, hanger plates, felt panels, black hardware, console)
    Laid speakers re-solved: stands x +/-554.9, y 229.1, toe-in 31.0 deg; laptop tray 305 mm.
    near_check: 0 overlaps over 28 pairs; sightlines clear for both monitors and the laptop lid.
2026-11-06 feat: add Insta360 Link 2 Pro webcam (MON-03) clipped on the main monitor
    Sketchfab Link 2 mesh (CC BY, bswlife) converted by parts/src/MON-03_convert.py:
    scaled to the 58.9 mm spec height, clip rear leg unfolded onto the M32U panel edge,
    reduced by vertex clustering (quadric decimation tore the UV seams). Placed at the
    main monitor's top-edge centre (D25). assembly_finish now recreates the Readme render
    setup, which rebuilds used to drop. Variant desk_62x32 rebuilt.
